falkm1980/Mp3-Player_HTL/README.md

# Mp3-Player_HTL
MP3 Player, HTL Saalfelden
