falkm1980/Mp3-Player_HTL/MP3_Player/Gehäuse/BOX G407.JPG

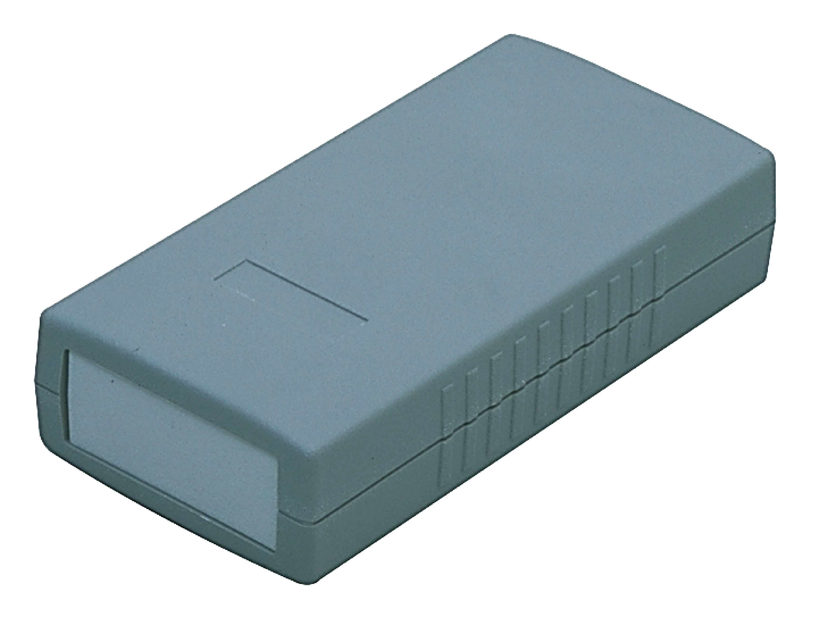
MP3_Player/Gehäuse/BOX G407.JPG
