falkm1980/Mp3-Player_HTL/MP3_Player/Gehäuse/BOXG407_LT.JPG

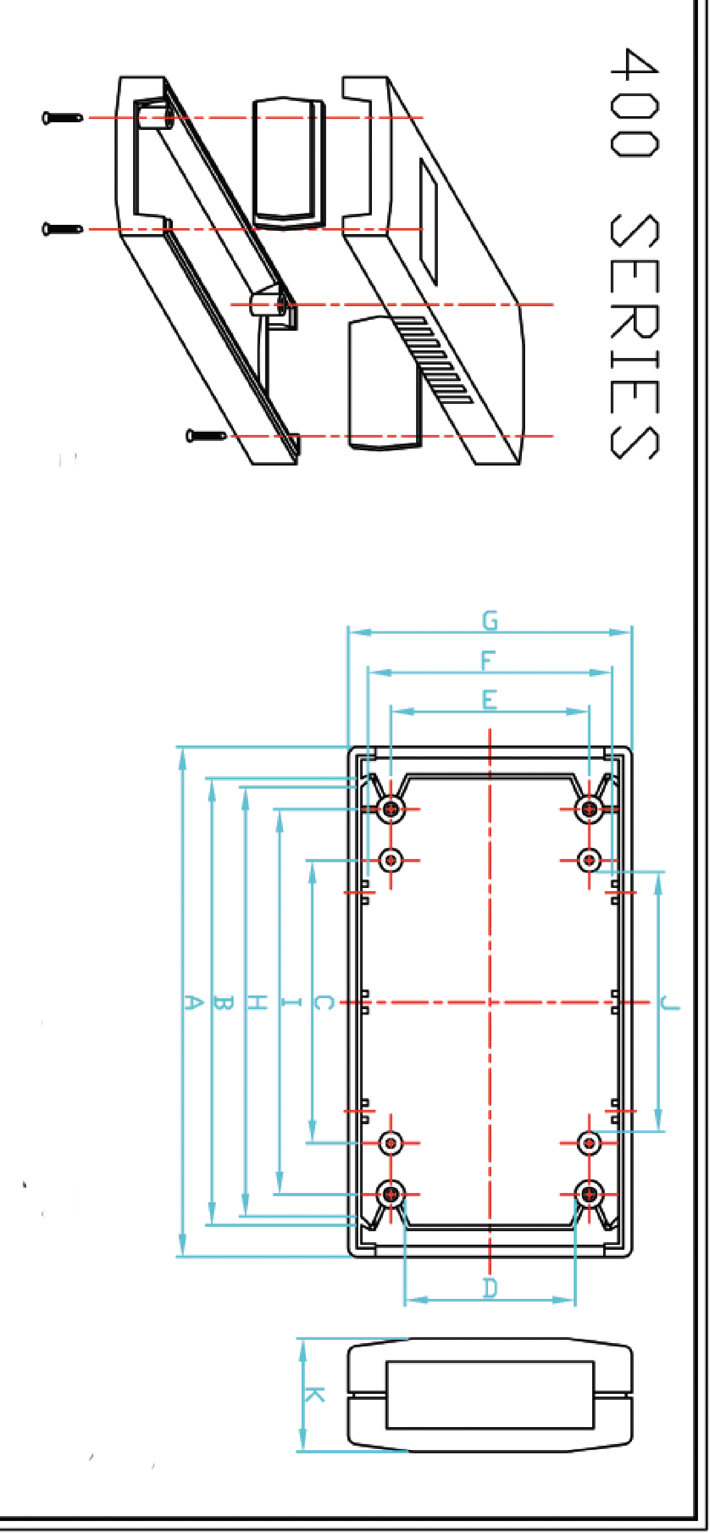
MP3_Player/Gehäuse/BOXG407_LT.JPG
