falkm1980/Mp3-Player_HTL/MP3_Player/Mouser/Warenkorb.PNG

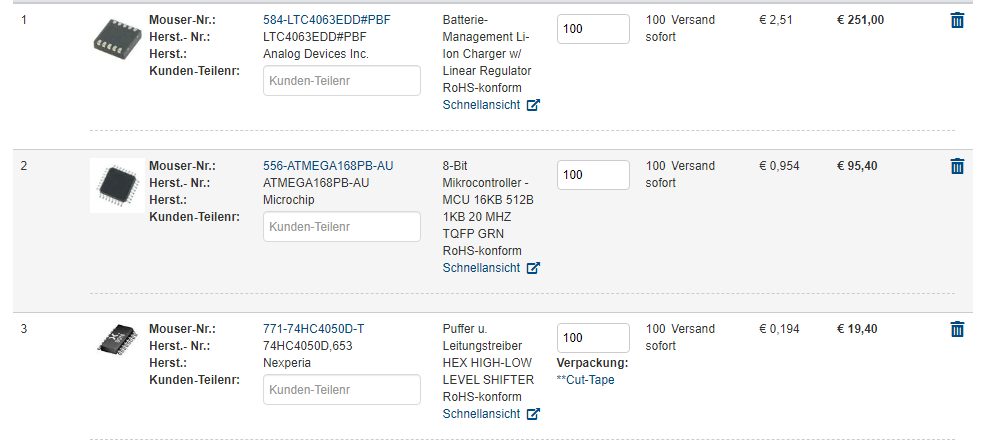
MP3_Player/Mouser/Warenkorb.PNG
