falkm1980/Mp3-Player_HTL/MP3_Player/Stückliste/MP3_Player_Stückliste.xlsx

 |  | Stückliste MP3 Player |  | RS |  |  |  | Bibliothek
Pos | Stück | Bezeichnung | Beschreibung | Bestellnummer | Gehäuse | Lieferant | Preis
 |  | ATMEGA 168 | Prozessor | 922-0749
 |  | VS1011E | Audio IC
 |  | BTM-222_Serial | Bluetooth
 |  | Quarz | 20MHz | 148-5634
 |  | Quarz | 12MHz | 148-5359
 |  | Klinkenbuchse |  | 909-2238 | Testboard | RS | 1.386
 |  | Klinkenbuchse | RS | 513-0421 | Testboard | RS | 1.42 | con_Hirschmann
 |  | Klinkenbuchse | Reichelt | LUM1503-02 | SMD | Reichelt
 |  | Klinkenbuchse | Reichelt | LUM1503-07 | Draht | Reichelt
 |  | LTC3455 |  | 153-3383
 |  | Elko | 10µ | 136-2654 | 1206 |  | 0.158
 |  | Elko | 47µ | 136-2598 | 1206
 |  | Kondensator | 27pF | 169-9964
 |  | LED Rot |  | 862-4695 |  |  | 0.097
 |  | LED Grün |  | 862-4691 |  |  | 0.1
 |  | LTC4063 | Mouser
 |  | Accu | Conrad | 252031-62
 |  | Accu | Mouser | 406-ASR00035
 |  | Gehäuse | Nedis | BOX G404
 |  | Akku | Reichelt | Akku 30083
 |  | Akku | Reichelt | AKKU CP 38 | 500mA
 |  | USB | RS | 136-2263
 |  | C1 | 33p | Bestellnummer | R1206
 |  | C2 | 33p |  | R1206
 |  | C3 | 100n |  | R1206
 |  | C4 | 100n |  | R1206
 |  | C5 | 100n |  | R1206
 |  | C6 | 100µ/16V |  | DU-6,3x7,7
 |  | C7 | 100µ/16V |  | DU-6,3x7,8
 |  | C8 | 22p |  | R1206
 |  | C9 | 22p |  | R1206
 |  | C10 | 2,2µ |  | R0805
 |  | C11 | 1µ |  | R0805
 |  | C12 | 0,1µ |  | R0805
 |  | R1 | 1M |  | R0805
 |  | R2 | 10K |  | 0207/10
 |  | R3 | 100K |  | R1206
 |  | R4 | 100K |  | R1206
 |  | R5 | 100K |  | R0805
 |  | R6 | 100K |  | R0806
 |  | R7 | 100K |  | R1206
 |  | R8 | 440K |  | R0806
 |  | R9 | 160K |  | R0806
 |  | R10 | 330R |  | R0806
 |  | R11 | 1k8 |  | R0806
 |  | R12 | 150R |  | R0806
 |  | R13 | 1K8 |  | R1206
 |  | R14 | 100K |  | R0806
 |  | R15 | 2M |  | R0806
 |  | R16 | 10K |  | 0207/10
 |  | R17 | 10K |  | 0207/10
 |  | R18 | 100K |  | 0207/10
 |  | R19 | 1K |  | 0207/10
