falkm1980/Mp3-Player_HTL/MP3_Player/RS-Components/Warenkorb.PNG

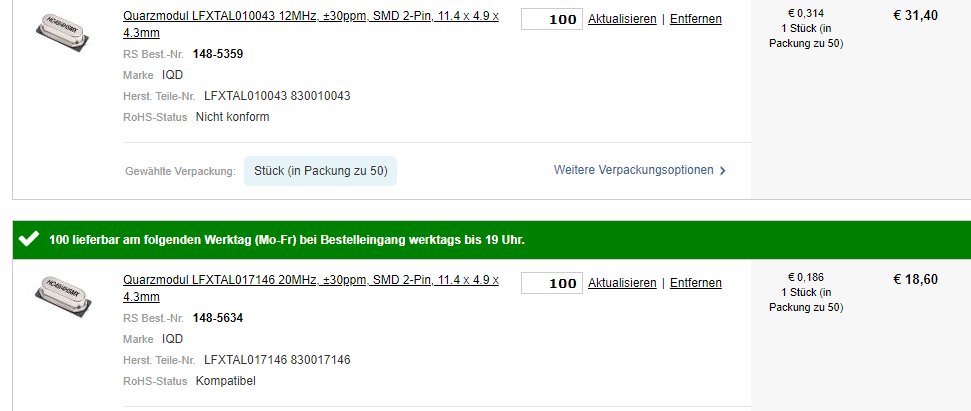
MP3_Player/RS-Components/Warenkorb.PNG
