falkm1980/Mp3-Player_HTL/EvaluationBoardLabor/datasheet/PCBA_rev4 2/Test Points/Assembly Testpoint Report for ATmega328P_Xplained_Mini_release_rev4.txt

Net         Name        X Coord     Y Coord     Side        Hole Size   Type        
PC0         J203-1          6.35mm     20.32mm  Bottom             1mm  Through hole
PC1         J203-2          6.35mm     17.78mm  Bottom             1mm  Through hole
PC3         J203-4          6.35mm      12.7mm  Bottom             1mm  Through hole
PC2         J203-3          6.35mm     15.24mm  Bottom             1mm  Through hole
PC5         J203-6          6.35mm      7.62mm  Bottom             1mm  Through hole
PC4         J203-5          6.35mm     10.16mm  Bottom             1mm  Through hole
PD0         J201-1         54.61mm      7.62mm  Bottom             1mm  Through hole
PD1         J201-2         54.61mm     10.16mm  Bottom             1mm  Through hole
PD3         J201-4         54.61mm     15.24mm  Bottom             1mm  Through hole
PD2         J201-3         54.61mm      12.7mm  Bottom             1mm  Through hole
PD6         J201-7         54.61mm     22.86mm  Bottom             1mm  Through hole
PD7         J201-8         54.61mm      25.4mm  Bottom             1mm  Through hole
PD5         J201-6         54.61mm     20.32mm  Bottom             1mm  Through hole
PD4         J201-5         54.61mm     17.78mm  Bottom             1mm  Through hole
PB4         J200-5         54.61mm    39.624mm  Bottom             1mm  Through hole
PB5         J200-6         54.61mm    42.164mm  Bottom             1mm  Through hole
AREF_TARGET J200-8         54.61mm    47.244mm  Bottom             1mm  Through hole
PB2         J200-3         54.61mm    34.544mm  Bottom             1mm  Through hole
PB3         J200-4         54.61mm    37.084mm  Bottom             1mm  Through hole
PB1         J200-2         54.61mm    32.004mm  Bottom             1mm  Through hole
PB0         J200-1         54.61mm    29.464mm  Bottom             1mm  Through hole
PC4         J200-9         54.61mm    49.784mm  Bottom             1mm  Through hole
PC5         J200-10        54.61mm    52.324mm  Bottom             1mm  Through hole
PD3_UART_TXD1J104-1         16.51mm     48.26mm  Bottom             1mm  Through hole
PD2_UART_RXD1J104-2         16.51mm      50.8mm  Bottom             1mm  Through hole
TDI         J100-9          50.8mm    56.515mm  Bottom          0.65mm  Through hole
VCC_BOARD   J100-4         46.99mm    57.785mm  Bottom          0.65mm  Through hole
S\R\S\T\    J100-6         48.26mm    57.785mm  Bottom          0.65mm  Through hole
NetJ100_8   J100-8         49.53mm    57.785mm  Bottom          0.65mm  Through hole
NetJ100_7   J100-7         49.53mm    56.515mm  Bottom          0.65mm  Through hole
TMS         J100-5         48.26mm    56.515mm  Bottom          0.65mm  Through hole
TDO         J100-3         46.99mm    56.515mm  Bottom          0.65mm  Through hole
TCK         J100-1         45.72mm    56.515mm  Bottom          0.65mm  Through hole
VCC_TARGET  J204-2         34.24mm      4.94mm  Bottom             1mm  Through hole
PB3         J204-4          31.7mm      4.94mm  Bottom             1mm  Through hole
PB4         J204-1         34.24mm      7.48mm  Bottom             1mm  Through hole
PB5         J204-3          31.7mm      7.48mm  Bottom             1mm  Through hole
R\E\S\E\T\  J204-5         29.16mm      7.48mm  Bottom             1mm  Through hole
NetJ202_1   J202-1          6.35mm     43.18mm  Bottom             1mm  Through hole
VCC_TARGET  J202-2          6.35mm     40.64mm  Bottom             1mm  Through hole
VCC_P3V3    J202-4          6.35mm     35.56mm  Bottom             1mm  Through hole
RESET_SENSE J202-3          6.35mm      38.1mm  Bottom             1mm  Through hole
GND         J202-7          6.35mm     27.94mm  Bottom             1mm  Through hole
VCC_VIN     J202-8          6.35mm      25.4mm  Bottom             1mm  Through hole
VCC_P5V0    Free-0          3.81mm     33.02mm  Bottom             1mm  Through hole
ADC6        Free-5         16.51mm      25.4mm  Bottom             1mm  Through hole
ADC7        Free-5         16.51mm     22.86mm  Bottom             1mm  Through hole
GND         Via            29.65mm     67.33mm  Bottom          0.25mm  Through hole
NetD100_1   Via           29.275mm   35.4457mm  Bottom          0.25mm  Through hole
VCC_VBUS    Via            34.35mm    67.275mm  Bottom          0.25mm  Through hole
USBD_P      Via            29.65mm      68.6mm  Bottom          0.25mm  Through hole
USBD_N      Via               31mm      68.6mm  Bottom          0.25mm  Through hole
POWER_ENABLEVia          27.8775mm    38.825mm  Bottom          0.25mm  Through hole
NetU100_8   Via          27.6477mm   52.1667mm  Bottom          0.25mm  Through hole
NetU100_12  Via           26.075mm   49.6397mm  Bottom          0.25mm  Through hole
DEBUGWIRE   Via             28.7mm      42.2mm  Bottom          0.25mm  Through hole
PB7         Via            30.25mm    16.075mm  Bottom          0.25mm  Through hole
NetU100_18  Via          24.9262mm   46.0273mm  Bottom          0.25mm  Through hole
NetU100_22  Via            25.85mm    43.125mm  Bottom          0.25mm  Through hole
NetU100_19  Via           23.975mm    42.875mm  Bottom          0.25mm  Through hole
NetJ102_2   Via          33.1836mm   42.8189mm  Bottom          0.25mm  Through hole
EXT_CLK     Via            29.85mm      41.5mm  Bottom          0.25mm  Through hole
