falkm1980/Mp3-Player_HTL/MP3_Player/Stückliste/Anleitung MP3-Gehäuse.docx

Anleitung MP3-Player Gehäuse gravieren

1. Beginnend muss der Computer eingeschalten werden und das Programm „GS 8 Gravostyle“ gestartet werden. Zusätzlich ist das Laserschneidegerät, wie in den nachfolgenden Bildern zu sehen, ebenfalls zu starten.

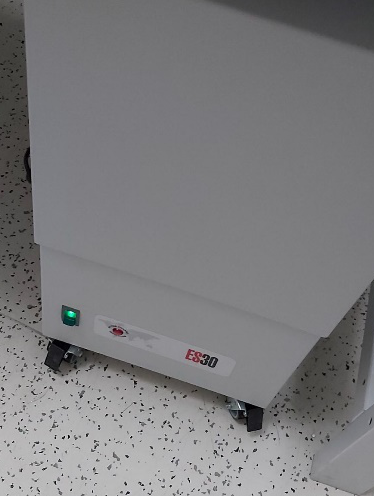
[picture p5: figure]
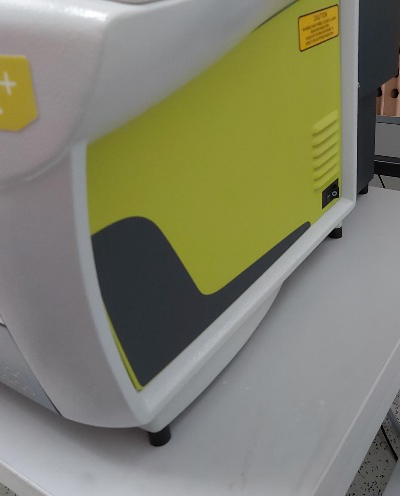
[picture p6: figure]
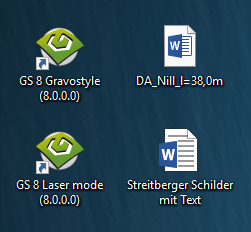
[picture p7: figure]
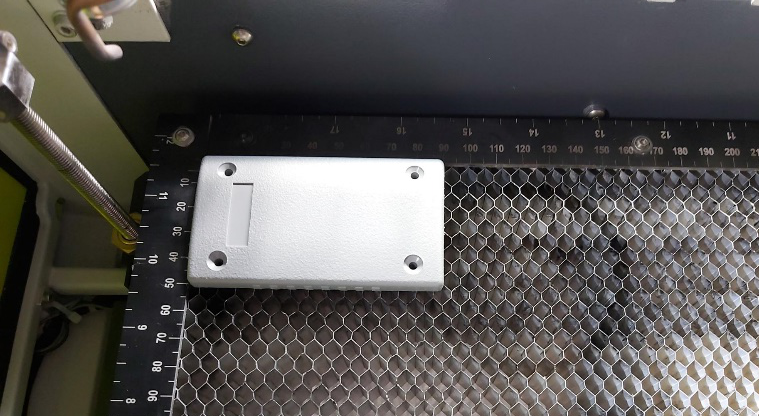
[picture p8: figure]

2. Dann muss als erstes der schmälere Teil des Gehäuses, mit der Einkerbung nach links, in die Lasermaschine eingelegt werden.
3. Danach muss im Laserprogramm in „Dateien öffnen“ der Richtige Ablauf gewählt werden. Als erstes wird in diesem Fall „MP3_Lochausschnitt“ geöffnet. Sobald die Datei geöffnet ist, kann wie im unteren Bild ersichtlich auf Beschriften und schließlich auf Start geklickt werden um den Laser zu starten.

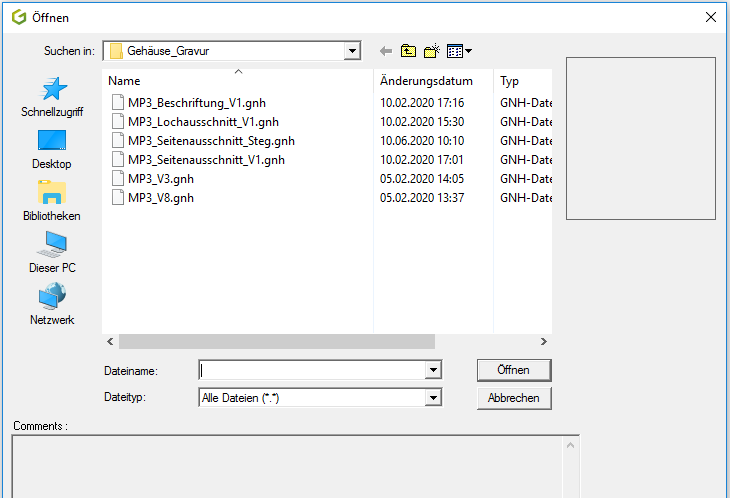
[picture p9: figure]
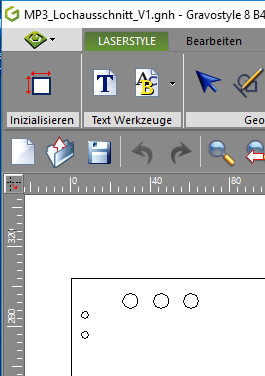
[picture p10: figure]
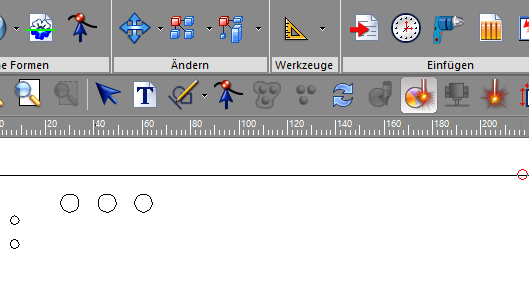
[picture p11: figure]
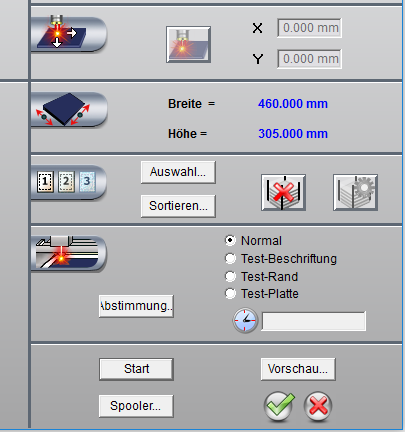
[picture p12: figure]

4. Um den Ablauf an der Lasermaschine beginnen zu können, muss man jedes Mal den grünen Knopf betätigen.

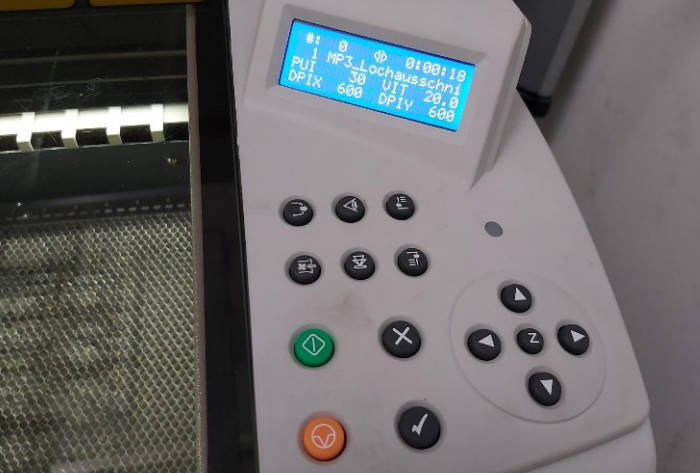
[picture p13: figure]

5. Im nächsten Schritt wird wieder in Dateien der nächste Ablauf ausgewählt –

„MP3_Beschriftung“. Das eingelegte Gehäuseteil bleibt dabei an der gleichen Stelle. Die weiteren Schritte sind gleich wie bei den Punkten 3 und 4.

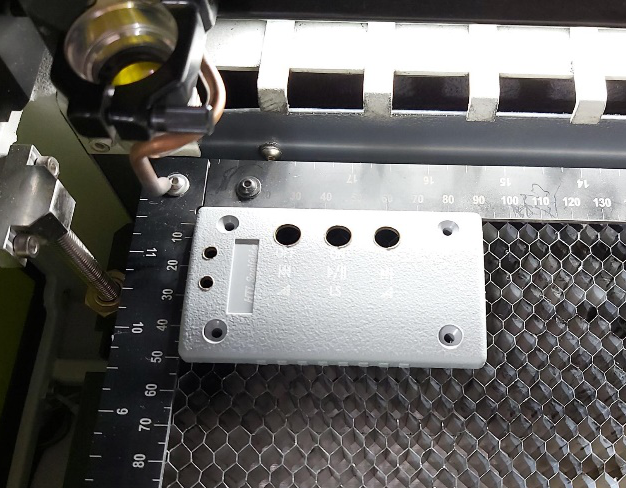
[picture p14: figure]
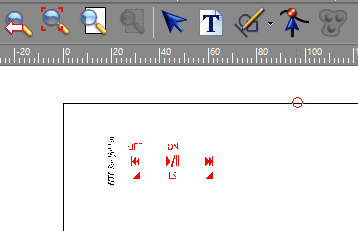
[picture p15: figure]

6. Nun muss das breitere Gehäuseteil mit der Einkerbung nach rechts Hochkant, wie im Bild ersichtlich, an das Aluminiumstück, mit Tixo, befestigt werden. Und anschließend wird es wieder in das Gerät eingelegt.

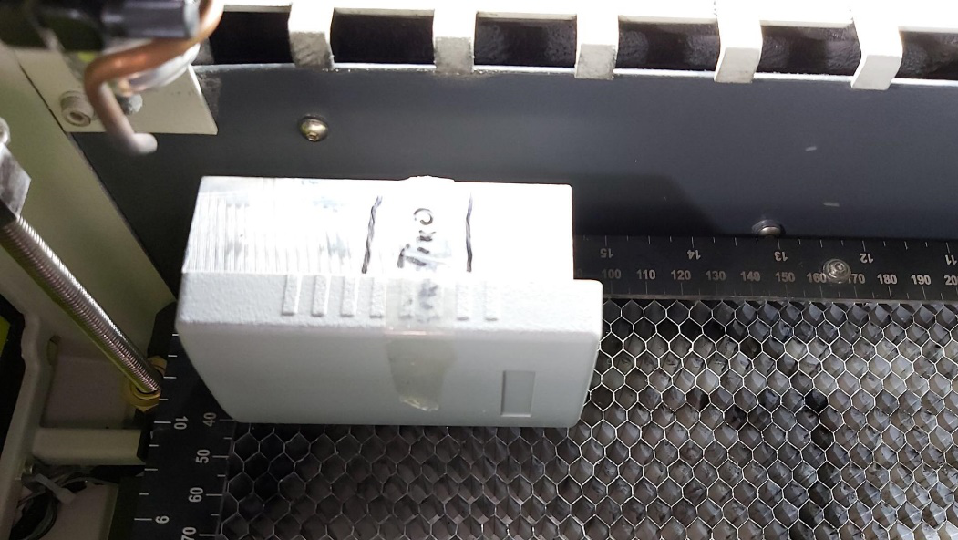
[picture p16: figure]

7. Danach wird wieder der richtige Ablauf in den Dateien ausgewählt – „MP3_Seitenausschnitt_Steg“. Die nachfolgenden Schritte sind wieder identisch zu den Punkten bei 3 und 4. Beim Seitenausschnitt muss das Programm zwei Mal durchlaufen um so einen Durchschnitt zu gewährleisten das heißt einfach nochmal auf Beschriften und Starten klicken.

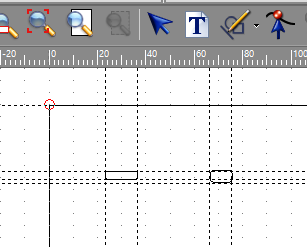
[picture p17: figure]
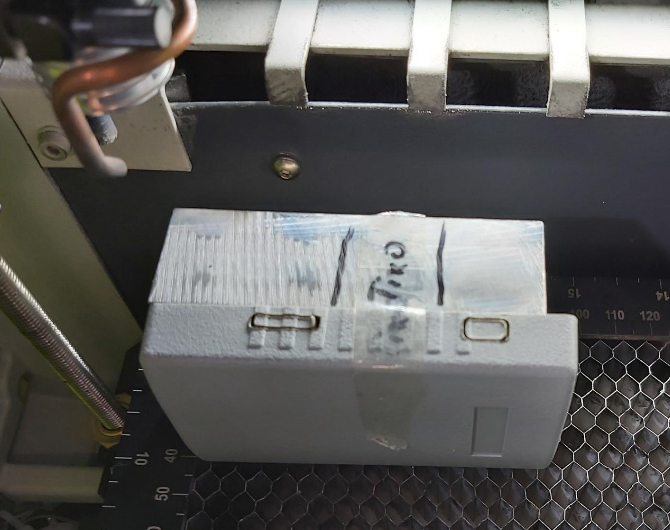
[picture p18: figure]
