falkm1980/Mp3-Player_HTL/MP3_Player/Stückliste/Platine Anleitung.docx

MP3-Player Projekt Anleitung zur Erstellung der Platine

1. Rohmaterial zuschneiden.

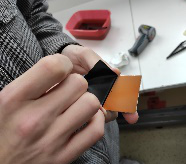
[picture p19: figure]

2. Schutzfolie entfernen.

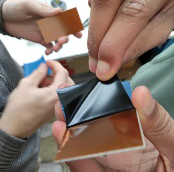
[picture p20: figure]
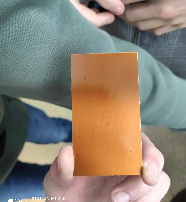
[picture p21: figure]

3. Platine mit UV Licht belichten um das Platinen Layout aufzubringen.

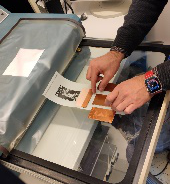
[picture p22: figure]
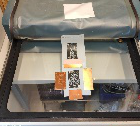
[picture p23: figure]
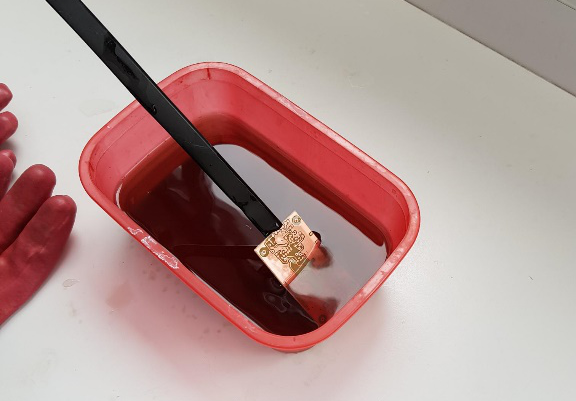
[picture p24: figure]

4. Entwickeln mit Natriumhydroxid [NaOh] um den Foto Lack zu lösen.
5. Ätzen mit Natriumpersulfat [Na2S2O8] um das Kupfer zu entfernen und die Leiterbahnen freizulegen

Durchs Ätzen Wird die Flüssigkeit blau, da sich das Kupfer darin löst.

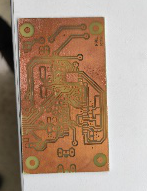
[picture p25: figure]
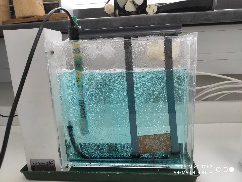
[picture p26: figure]
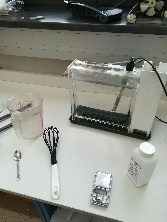
[picture p27: figure]

6. Bohren der Übergänge nach Schaltplan

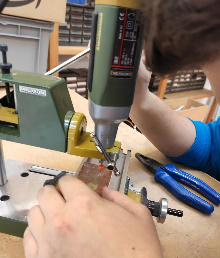
[picture p28: figure]
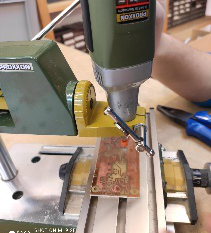
[picture p29: figure]

7. Nochmals belichten und entwickeln um den restlichen Foto Lack zu entfernen

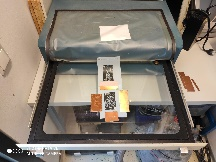
[picture p30: figure]
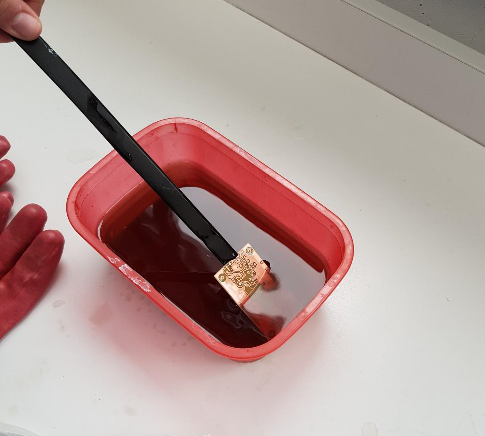
[picture p31: figure]
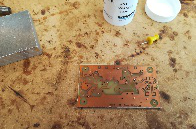
[picture p32: figure]

8. Nieten um eine Verbindung von der Top Seite auf die Botton Seite zu gewährleisten
9. Abschließend die Platine bestücken und testen bevor sie in das Gehäuse verbaut wird
