falkm1980/Mp3-Player_HTL/Testboard/SMD Adapter/Pinbelegung_Adapter.xlsm

TQFP32 | DIL32 |  | SOIC28 | DIL28
1 | 21 |  | 1
2 | 22 |  | 2
3 | 23 |  | 3
4 | 24 |  | 4
5 | 25 |  | 5
6 | 26 |  | 6
7 | 27 |  | 7
8 | 28 |  | 8
9 | 29 |  | 9
10 | 30 | x | 10
11 | 31 | x | 11
12 | 32 | x | 12
13 | 1 |  | 13
14 | 2 |  | 14
15 | 3 |  | 15
16 | 4 |  | 16
17 | 5 |  | 17
18 | 6 | x | 18
19 | 7 | x | 19
20 | 8 | x | 20
21 | 9 |  | 21
22 | 10 | x | 22
23 | 11 |  | 23
24 | 12 |  | 24
25 | 13 | x | 25
26 | 14 |  | 26
27 | 15 |  | 27
28 | 16 |  | 28
29 | 17
30 | 18 | x
31 | 19 | x
32 | 20
