falkm1980/Mp3-Player_HTL/EvaluationBoardLabor/pcb/mp3playerLabor_v1.pdf

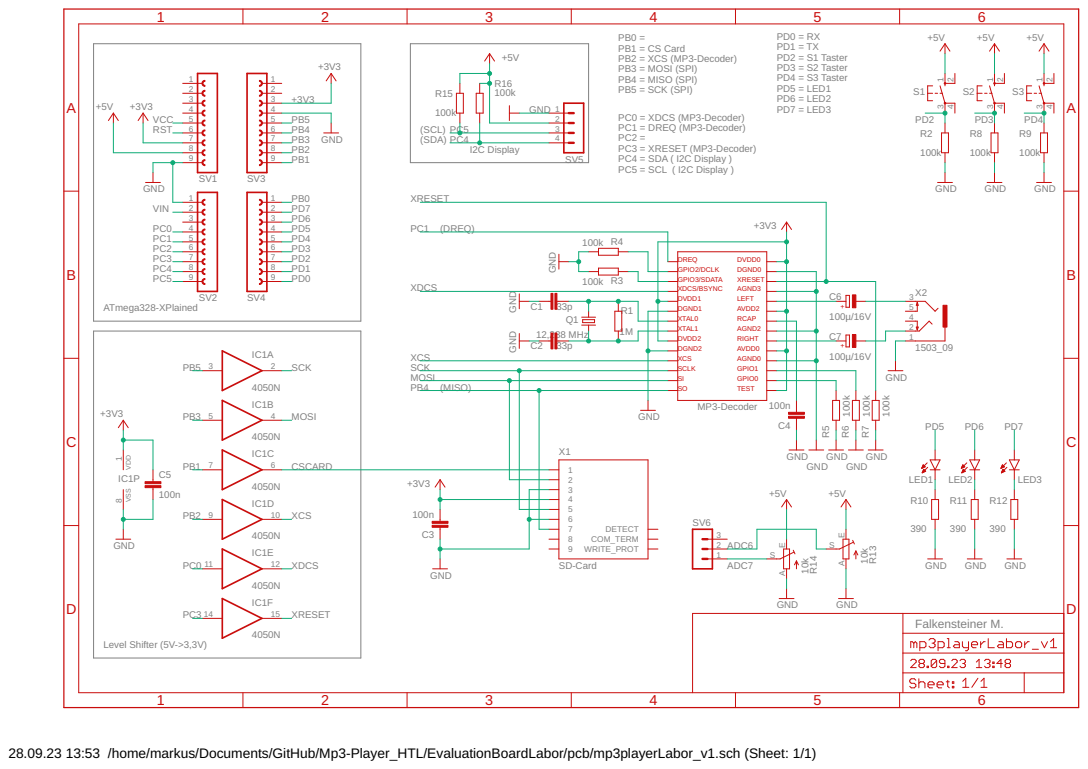
[picture p33: page 1]

28.09.23 13:53 /home/markus/Documents/GitHub/Mp3-Player_HTL/EvaluationBoardLabor/pcb/mp3playerLabor_v1.sch (Sheet: 1/1)
