falkm1980/Mp3-Player_HTL/EvaluationBoardLabor/pcb/mp3playerLabor_v1.brd.pdf

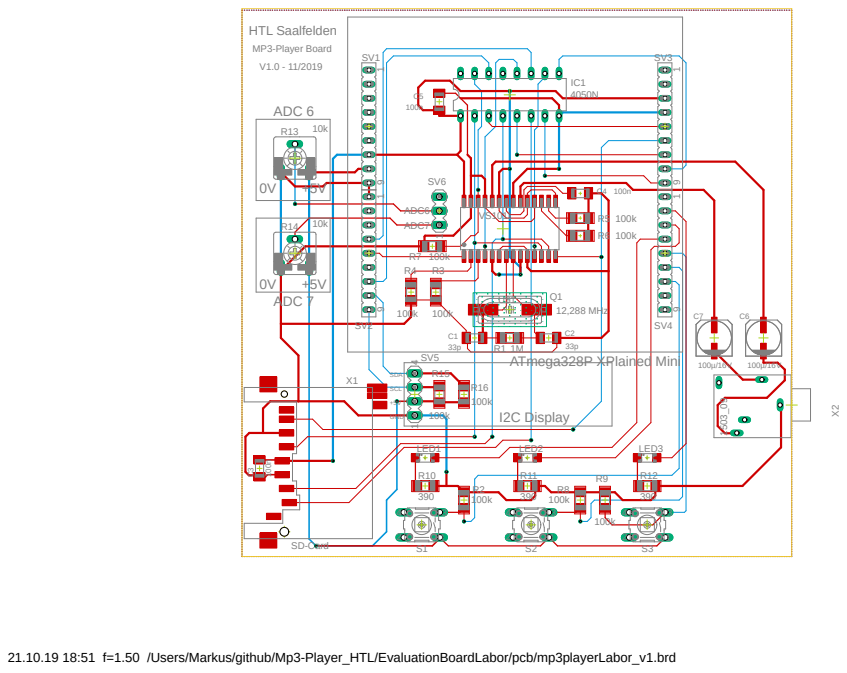
[picture p34: page 1]

21.10.19 18:51 f=1.50 /Users/Markus/github/Mp3-Player_HTL/EvaluationBoardLabor/pcb/mp3playerLabor_v1.brd
