falkm1980/Mp3-Player_HTL/(list of files, drawings)

Other design files:
EvaluationBoardLabor/datasheet/PCBA_rev4 2/ATmega328P_Xplained_Mini_CAD_source_PCBA_rev4/ATmega328P_Xplained_Mini.PrjPCB
EvaluationBoardLabor/datasheet/PCBA_rev4 2/ATmega328P_Xplained_Mini_CAD_source_PCBA_rev4/ATmega328P_Xplained_Mini_Programmer.SchDoc
EvaluationBoardLabor/datasheet/PCBA_rev4 2/ATmega328P_Xplained_Mini_CAD_source_PCBA_rev4/ATmega328P_Xplained_Mini_Target.SchDoc
EvaluationBoardLabor/datasheet/PCBA_rev4 2/ATmega328P_Xplained_Mini_CAD_source_PCBA_rev4/ATmega328P_Xplained_Mini_TopLevel.SchDoc
