falkm1980/Mp3-Player_HTL/EvaluationBoardLabor/pcb/mp3playerLabor_v1.brd

## EAGLE design EvaluationBoardLabor/pcb/mp3playerLabor_v1.brd (2019-10-12)

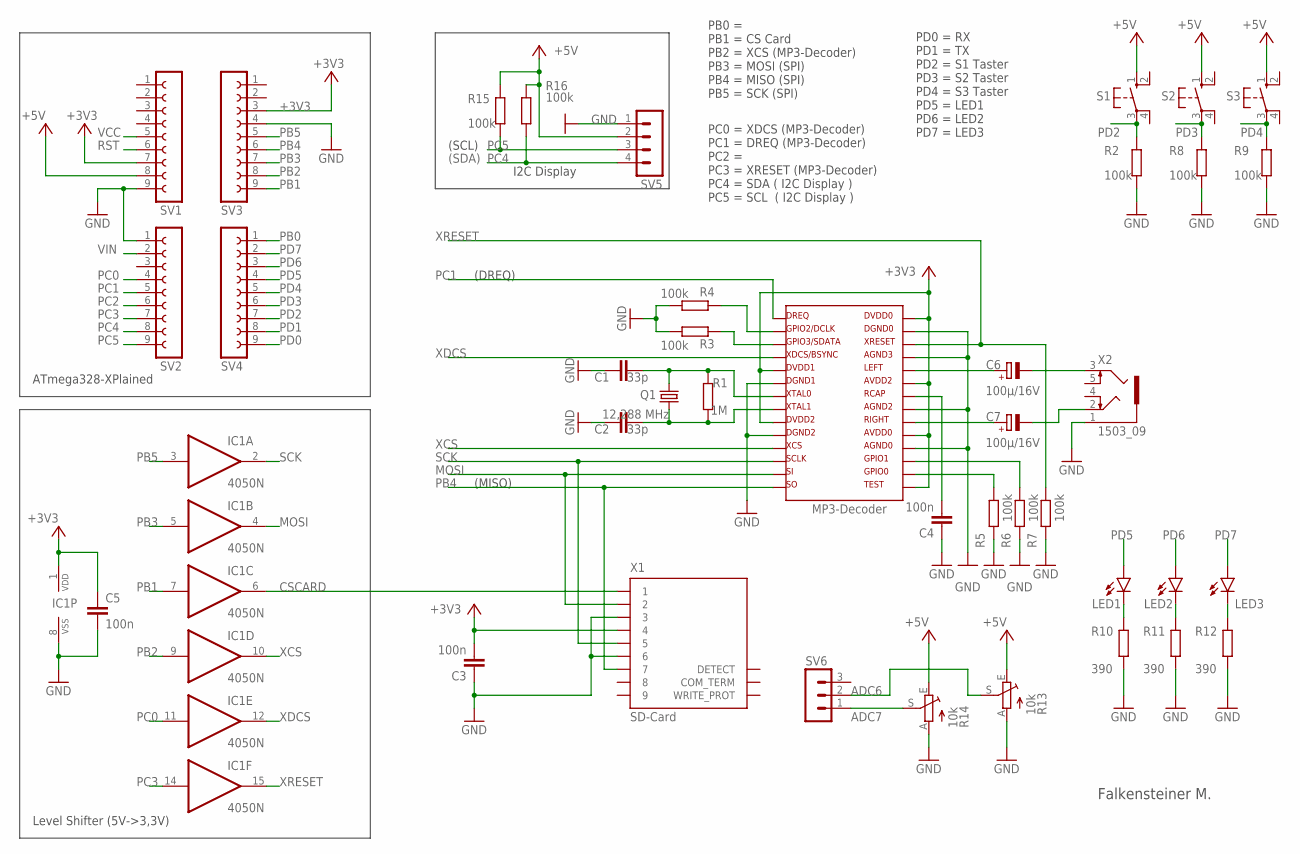
[picture p35: schematic mp3playerLabor_v1.sch]

Parts:
C1, C2: 33p; C1206K
C3, C4, C5: 100n; C1206K
C6, C7: 100µ/16V; UD-6,3X7,7_NICHICON
IC1: 4050N; DIL16
LED1, LED2, LED3: LEDSML1206; SML1206
Q1: 12,288 MHz; HC49UP
R1: 1M; R1206
R2, R3, R4, R5, R6, R7, R8, R9, R15, R16: 100k; R1206
R10, R11, R12: 390; R1206
R13, R14: 10k; CA6V
S1, S2, S3: 10-XX; B3F-10XX
SV1, SV2, SV3, SV4: FE09-1; FE09
SV5: MA04-1
SV6: MA03-1
U$1: VS1011; SOIC-28
X1: SD-Card; FPS009-3000
X2: 1503_09

Connections:
+3V3: C3.2, C5.1, IC1.1 (VDD), SV1.7, SV3.3, U$1.5, U$1.9, U$1.15, U$1.19, U$1.23, U$1.28, X1.4
+5V: R13.E, R14.E, R15.1, R16.1, S1.1 (S), S2.1 (S), S3.1 (S), SV1.8, SV5.2
ADC6: R13.S, SV6.2
ADC7: R14.S, SV6.1
CSCARD: IC1.6 (O), X1.1
GND: C1.1, C2.1, C3.1, C4.1, C5.2, IC1.8 (VSS), R2.2, R3.2, R4.2, R5.2, R6.2, R7.2, R8.2, R9.2, R10.2, R11.2, R12.2, R13.A, R14.A, SV1.9, SV2.1, SV3.4, SV5.1, U$1.6, U$1.10, U$1.18, U$1.21, U$1.25, U$1.27, X1.3, X1.6, X2.1
MOSI: IC1.4 (O), U$1.13, X1.2
unnamed: LED1.C, R10.1
unnamed: LED2.C, R11.1
unnamed: C2.2, Q1.1, R1.1, U$1.8
unnamed: LED3.C, R12.1
unnamed: C4.2, U$1.22
unnamed: R3.1, U$1.3
unnamed: C1.2, Q1.2, R1.2, U$1.7
unnamed: R4.1, U$1.2
unnamed: R6.1, U$1.17
unnamed: R5.1, U$1.16
unnamed: C7.+, U$1.20
unnamed: C6.+, U$1.24
unnamed: C6.-, X2.3
unnamed: C7.-, X2.2
PB0: SV4.1
PB1: IC1.7 (I), SV3.9
PB2: IC1.9 (I), SV3.8
PB3: IC1.5 (I), SV3.7
PB4: SV3.6, U$1.14, X1.7
PB5: IC1.3 (I), SV3.5
PC0: IC1.11 (I), SV2.4
PC1: SV2.5, U$1.1
PC2: SV2.6
PC3: IC1.14 (I), SV2.7
PC4: R16.2, SV2.8, SV5.4
PC5: R15.2, SV2.9, SV5.3
PD0: SV4.9
PD1: SV4.8
PD2: R2.1, S1.3, SV4.7
PD3: R8.1, S2.3, SV4.6
PD4: R9.1, S3.3, SV4.5
PD5: LED1.A, SV4.4
PD6: LED2.A, SV4.3
PD7: LED3.A, SV4.2
RST: SV1.6
SCK: IC1.2 (O), U$1.12, X1.5
VCC: SV1.5
VIN: SV2.2
XCS: IC1.10 (O), U$1.11
XDCS: IC1.12 (O), U$1.4
XRESET: IC1.15 (O), R7.1, U$1.26

Notes on the sheet:
Falkensteiner M.
PB0 = PB1 = CS Card PB2 = XCS (MP3-Decoder) PB3 = MOSI (SPI) PB4 = MISO (SPI) PB5 = SCK (SPI)
(MISO)
ATmega328-XPlained
PC0 = XDCS (MP3-Decoder) PC1 = DREQ (MP3-Decoder) PC2 = PC3 = XRESET (MP3-Decoder) PC4 = SDA ( I2C Display ) PC5 = SCL ( I2C Display )
Level Shifter (5V->3,3V)
PD0 = RX PD1 = TX PD2 = S1 Taster PD3 = S2 Taster PD4 = S3 Taster PD5 = LED1 PD6 = LED2 PD7 = LED3
MP3-Decoder
(DREQ)
(SCL)
(SDA)
I2C Display

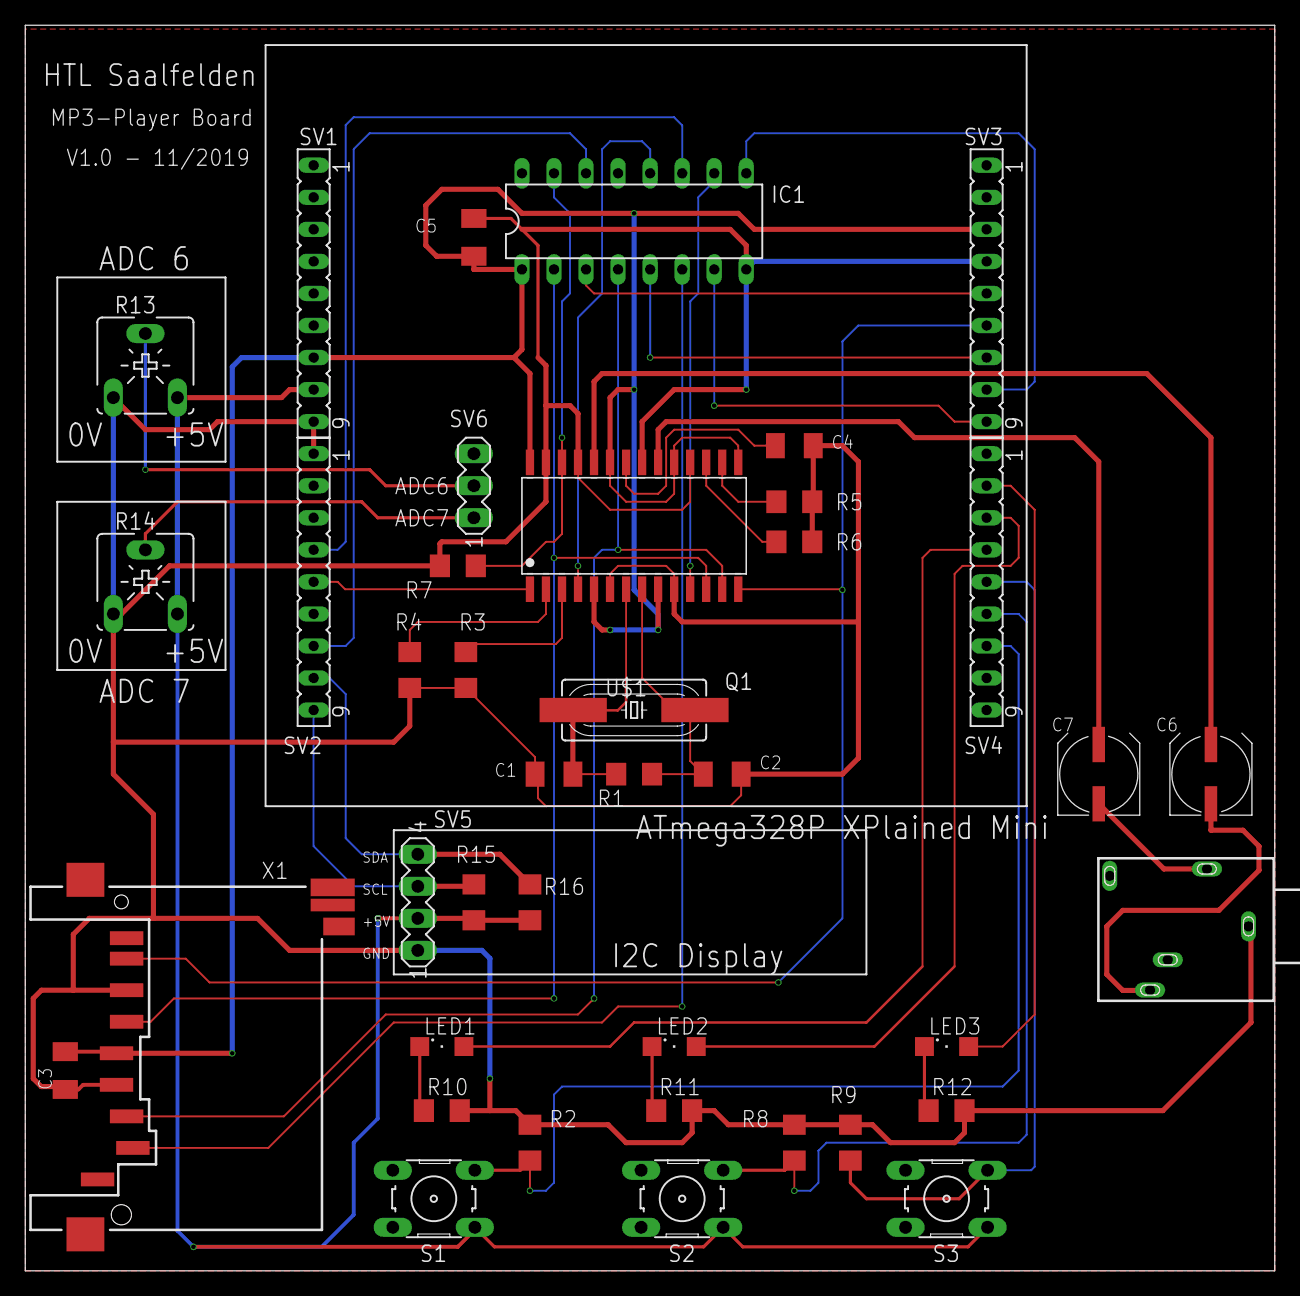
[picture p36: board mp3playerLabor_v1.brd from above]

Board: 2 copper layers, 99.0 x 98.7 mm, 40 parts (0 on the bottom side), 41 nets.
