falkm1980/Mp3-Player_HTL/MP3_Player/Platine_Version_6/mp3player_v6_Laderegler_LTC4063.brd

## EAGLE design MP3_Player/Platine_Version_6/mp3player_v6_Laderegler_LTC4063.brd (2019-05-24, an earlier design)

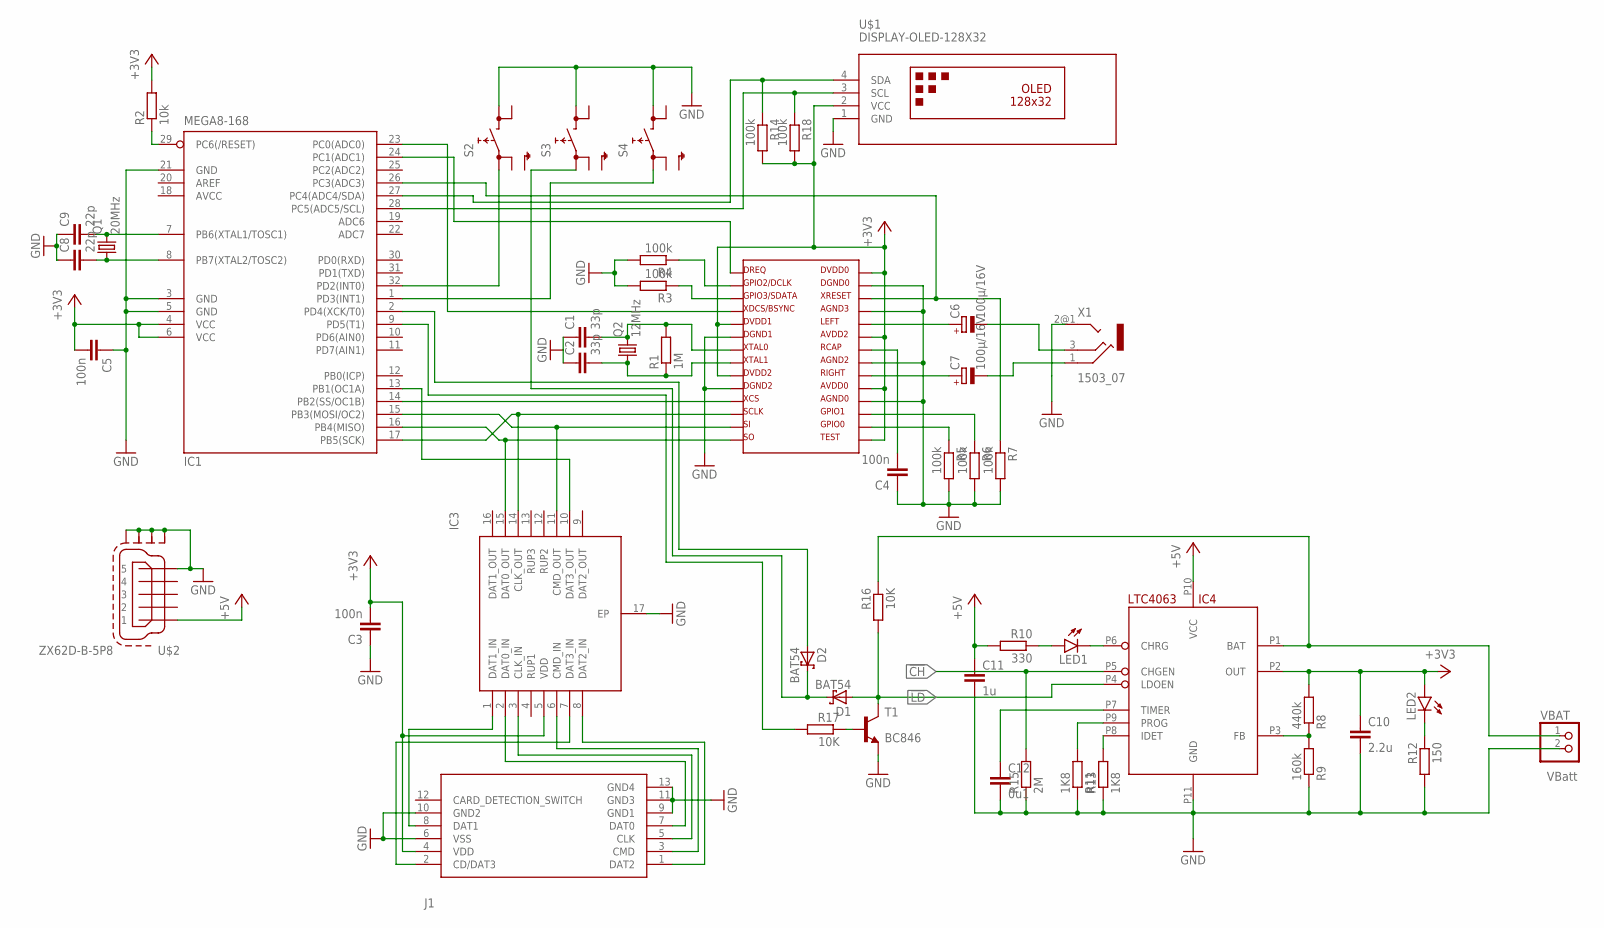
[picture p37: schematic mp3player_v6_Laderegler_LTC4063.sch]

Parts:
C1, C2: 33p; C1206K
C3, C4, C5: 100n; C1206K
C6, C7: 100µ/16V; UD-6,3X7,7_NICHICON
C8, C9: 22p; C1206K
C10: 2.2u; C0805K
C11: 1u; C0805K
C12: 0u1; C0805K
D1, D2: BAT54; SOT23
IC1: MEGA8-168; TQFP32-08
IC2: VS1011; SOIC-28
IC3: ECLAMP2410P.TCT; SON50P160X400X65-17N
IC4: LTC4063
J1: DM3CS-SF
LED1, LED2: LG_T679-E1F1-1; PLCC2
Q1: 20MHz; HC49UP
Q2: 12MHz; HC49UP
R1: 1M; R0805
R2: 10k; 0207/7
R3, R4, R5, R6, R14, R18: 100k; R0805
R7: 100k; 0207/15
R8: 440k; R0805
R9: 160k; R0805
R10: 330; R0805
R11, R13: 1K8; R0805
R12: 150; R0805
R15: 2M; R0805
R16: 10K; 0207/7
R17: 10K; R0805
S2, S3, S4: SKHMPSE010; SKHMPXE010
T1: BC846; SOT23
U$1: DISPLAY-OLED-128X32
U$2: ZX62D-B-5P8
VBAT: PINHD-1X2; 1X02
X1: 1503_07

Connections:
!CH: IC4.P5 (CHGEN), R15.2
!LD: D1.1 (A), IC4.P4 (LDOEN), R16.2, T1.3 (C)
+3V3: C3.2, C5.2, C10.1, IC1.4 (VCC), IC1.6 (VCC), IC2.5, IC2.9, IC2.15, IC2.19, IC2.23, IC2.28, IC3.5 (VDD), IC4.P2 (OUT), J1.4 (VDD), LED2.A, R2.2, R8.2, R14.2, R18.2, U$1.2 (VCC)
+5V: C11.1, IC4.P10 (VCC), R10.2, U$2.P$1 (1)
AVCC: IC1.18 (AVCC)
GND: C1.1, C2.1, C3.1, C4.1, C5.1, C8.1, C9.1, C10.2, C11.2, C12.2, IC1.3 (GND), IC1.5 (GND), IC1.21 (GND), IC2.6, IC2.10, IC2.18, IC2.21, IC2.25, IC2.27, IC3.17 (EP), IC4.P11 (GND), J1.6 (VSS), J1.9 (GND1), J1.10 (GND2), J1.11 (GND3), J1.13 (GND4), R3.2, R4.2, R5.2, R6.2, R7.2, R9.1, R11.1, R12.2, R13.1, R15.1, S2.3 (2.1), S3.3 (2.1), S4.3 (2.1), T1.2 (E), U$1.1 (GND), U$2.P$5 (5), U$2.SH1, U$2.SH2, U$2.SH3, U$2.SH4, VBAT.2, X1.2@1 (2)
unnamed: IC1.17 (PB5(SCK)), IC2.12, IC3.14 (CLK_OUT)
unnamed: IC1.16 (PB4(MISO)), IC2.14, IC3.15 (DAT0_OUT)
unnamed: IC1.15 (PB3(MOSI/OC2)), IC2.13, IC3.11 (CMD_OUT)
unnamed: IC1.14 (PB2(SS/OC1B)), IC2.11
unnamed: C2.2, IC2.8, Q2.1, R1.1
unnamed: IC1.23 (PC0(ADC0)), IC2.4
unnamed: C4.2, IC2.22
unnamed: IC2.3, R3.1
unnamed: C1.2, IC2.7, Q2.2, R1.2
unnamed: IC2.2, R4.1
unnamed: IC1.32 (PD2(INT0)), S2.1 (1.1)
unnamed: IC2.17, R6.1
unnamed: IC2.16, R5.1
unnamed: IC1.24 (PC1(ADC1)), IC2.1
unnamed: D2.1 (A), IC1.2 (PD4(XCK/T0))
unnamed: IC1.26 (PC3(ADC3)), IC2.26, R7.1
unnamed: IC1.29 (PC6(/RESET)), R2.1
unnamed: C7.+, IC2.20
unnamed: C6.+, IC2.24
unnamed: IC1.1 (PD3(INT1)), S4.1 (1.1)
unnamed: C6.-, X1.3
unnamed: C7.-, X1.1
unnamed: C8.2, IC1.8 (PB7(XTAL2/TOSC2)), Q1.1
unnamed: C9.2, IC1.7 (PB6(XTAL1/TOSC1)), Q1.2
unnamed: IC3.1 (DAT1_IN), J1.8 (DAT1)
unnamed: IC3.8 (DAT2_IN), J1.1 (DAT2)
unnamed: IC4.P3 (FB), R8.1, R9.2
unnamed: IC3.7 (DAT3_IN), J1.2 (CD/DAT3)
unnamed: IC3.2 (DAT0_IN), J1.7 (DAT0)
unnamed: IC3.3 (CLK_IN), J1.5 (CLK)
unnamed: IC3.6 (CMD_IN), J1.3 (CMD)
unnamed: IC4.P1 (BAT), R16.1, VBAT.1
unnamed: LED1.A, R10.1
unnamed: IC4.P9 (PROG), R11.2
unnamed: IC4.P6 (CHRG), LED1.C
unnamed: LED2.C, R12.1
unnamed: IC4.P8 (IDET), R13.2
unnamed: C12.1, IC4.P7 (TIMER)
unnamed: IC1.27 (PC4(ADC4/SDA)), R14.1, U$1.4 (SDA)
unnamed: IC1.28 (PC5(ADC5/SCL)), R18.1, U$1.3 (SCL)
unnamed: IC1.13 (PB1(OC1A)), IC3.10 (DAT3_OUT)
unnamed: R17.1, T1.1 (B)
unnamed: IC1.9 (PD5(T1)), R17.2
unnamed: D1.3 (C), D2.3 (C), S3.1 (1.1)

Notes on the sheet:
VBatt

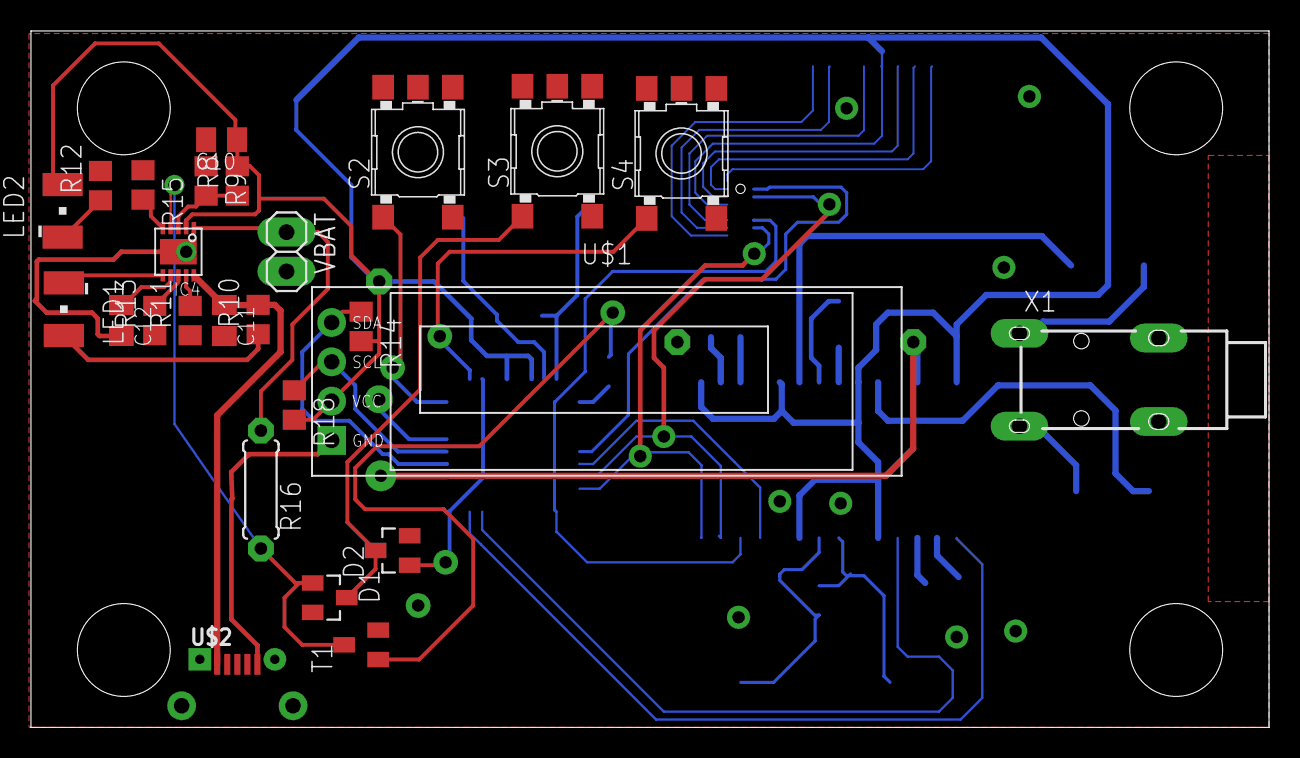
[picture p38: board mp3player_v6_Laderegler_LTC4063.brd from above]

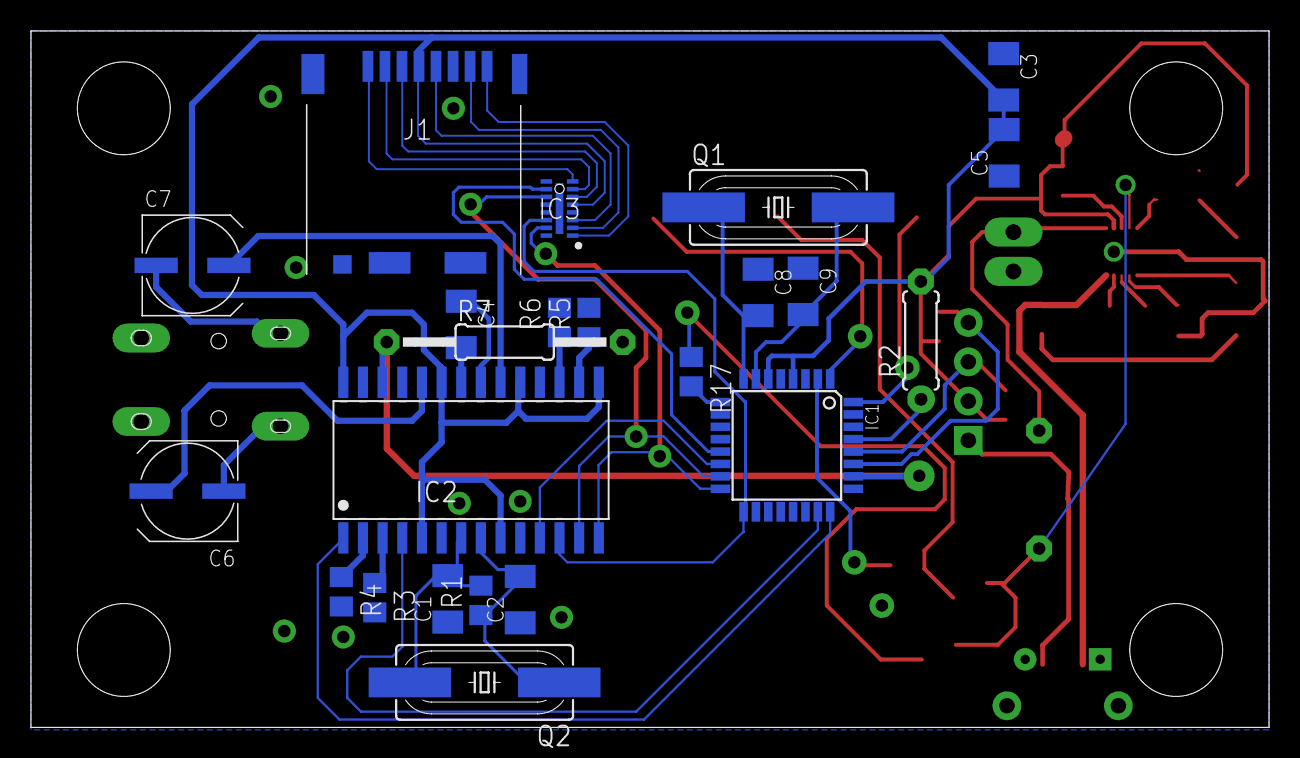
[picture p39: board mp3player_v6_Laderegler_LTC4063.brd from below]

Board: 2 copper layers, 80.0 x 45.0 mm, 49 parts (23 on the bottom side), 49 nets.
