falkm1980/Mp3-Player_HTL/MP3_Player/Laderegler_LTC4063/Eagle-LTC4063-master/Eagle-LTC4063-master/LTC4063-TestBoard_nicht SMD.brd

## EAGLE design MP3_Player/Laderegler_LTC4063/Eagle-LTC4063-master/Eagle-LTC4063-master/LTC4063-TestBoard_nicht SMD.brd (2019-09-27)

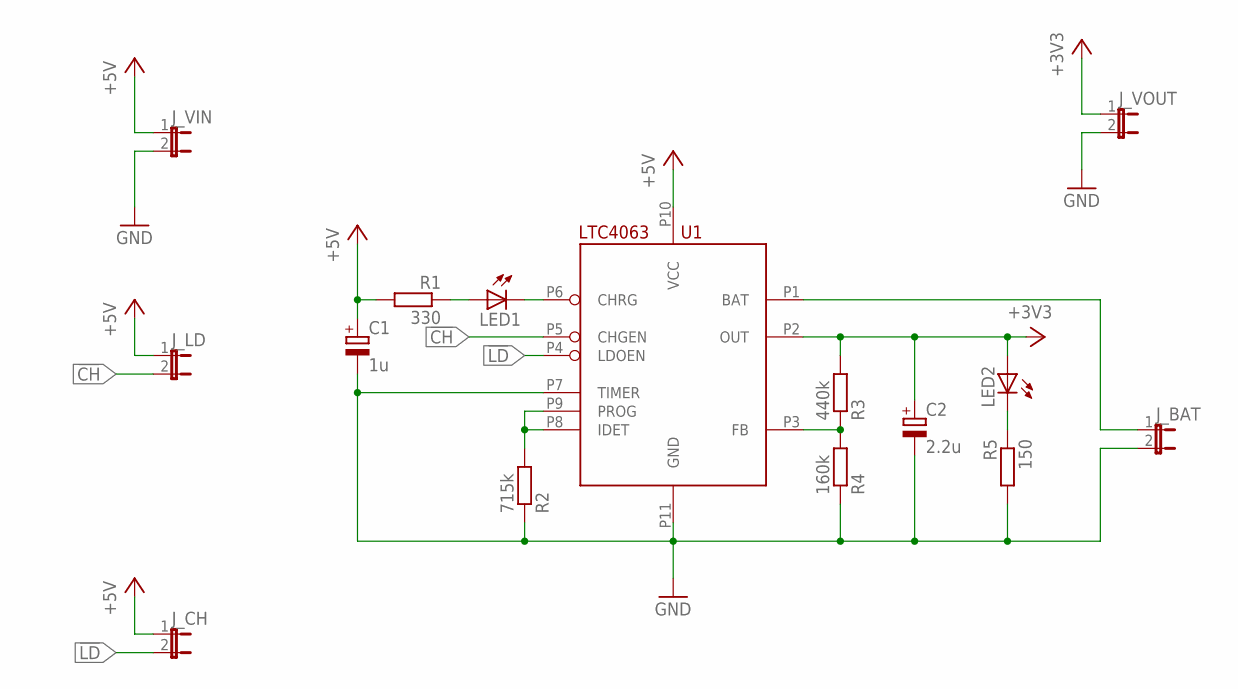
[picture p40: schematic LTC4063-TestBoard_nicht SMD.sch]

Parts:
C1: 1u; E2,5-6
C2: 2.2u; E2,5-6
J_BAT: JP1E; JP1
J_CH: JP1E; JP1
J_LD: JP1E; JP1
J_VIN: JP1E; JP1
J_VOUT: JP1E; JP1
LED1, LED2: LED3MM
R1: 330; 0207/7
R2: 715k; 0207/7
R3: 440k; 0207/7
R4: 160k; 0207/7
R5: 150; 0207/7
U1: LTC4063

Connections:
!CH: J_LD.2, U1.P5 (CHGEN)
!LD: J_CH.2, U1.P4 (LDOEN)
+3V3: C2.+, J_VOUT.1, LED2.A, R3.2, U1.P2 (OUT)
+5V: C1.+, J_CH.1, J_LD.1, J_VIN.1, R1.2, U1.P10 (VCC)
GND: C1.-, C2.-, J_BAT.2, J_VIN.2, J_VOUT.2, R2.1, R4.1, R5.2, U1.P7 (TIMER), U1.P11 (GND)
unnamed: R3.1, R4.2, U1.P3 (FB)
unnamed: J_BAT.1, U1.P1 (BAT)
unnamed: LED1.K (C), U1.P6 (CHRG)
unnamed: LED1.A, R1.1
unnamed: R2.2, U1.P8 (IDET), U1.P9 (PROG)
unnamed: LED2.K (C), R5.1

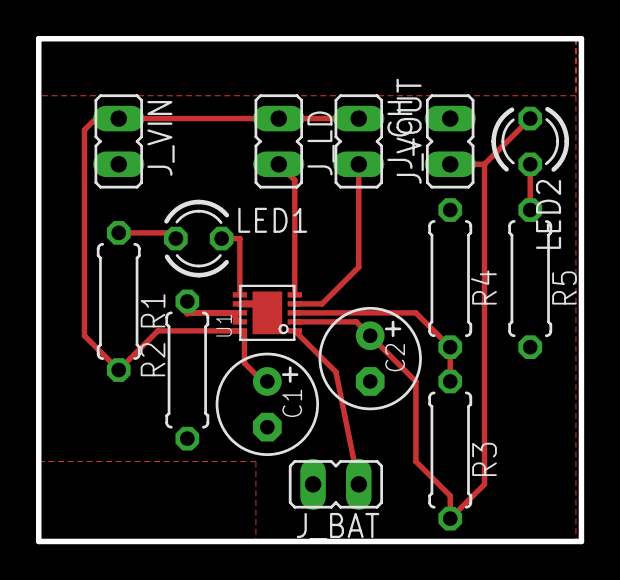
[picture p41: board LTC4063-TestBoard_nicht SMD.brd from above]

Board: 2 copper layers, 30.1 x 27.9 mm, 15 parts (0 on the bottom side), 11 nets.
