falkm1980/Mp3-Player_HTL/Testboard/SD_Kartenbuchse/SD_Card.brd

## EAGLE design Testboard/SD_Kartenbuchse/SD_Card.brd (2019-09-27)

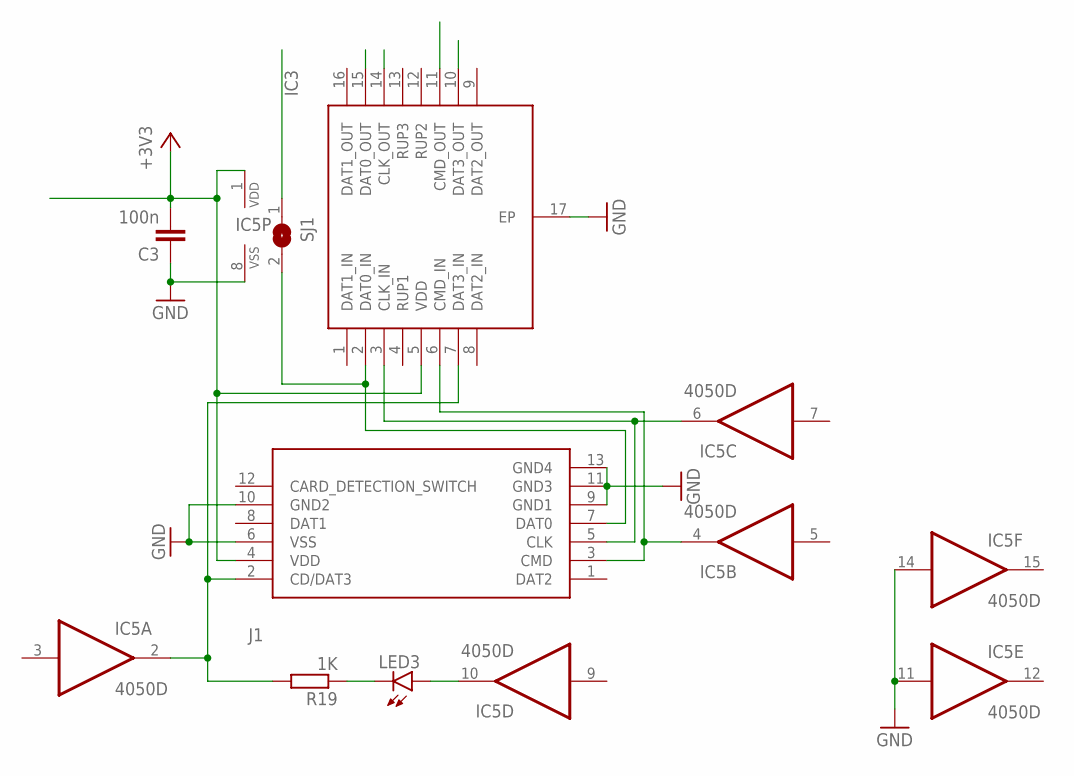
[picture p42: schematic SD_Card.sch]

Parts:
C3: 100n; C1206K
IC3: ECLAMP2410P.TCT; SON50P160X400X65-17N
IC5: 4050D; SO16
J1: DM3CS-SF
LED3: LG_T679-E1F1-1; PLCC2
R19: 1K; R1206
SJ1: SJ

Connections:
+3V3: C3.2, IC3.5 (VDD), IC5.1 (VDD), J1.4 (VDD)
GND: C3.1, IC3.17 (EP), IC5.8 (VSS), IC5.11 (I), IC5.14 (I), J1.6 (VSS), J1.9 (GND1), J1.10 (GND2), J1.11 (GND3), J1.13 (GND4)
unnamed: IC3.15 (DAT0_OUT), SJ1.1
unnamed: IC5.10 (O), LED3.A
unnamed: LED3.C, R19.1
unnamed: IC3.7 (DAT3_IN), IC5.2 (O), J1.2 (CD/DAT3), R19.2
unnamed: IC3.2 (DAT0_IN), J1.7 (DAT0), SJ1.2
unnamed: IC3.3 (CLK_IN), IC5.6 (O), J1.5 (CLK)
unnamed: IC3.6 (CMD_IN), IC5.4 (O), J1.3 (CMD)

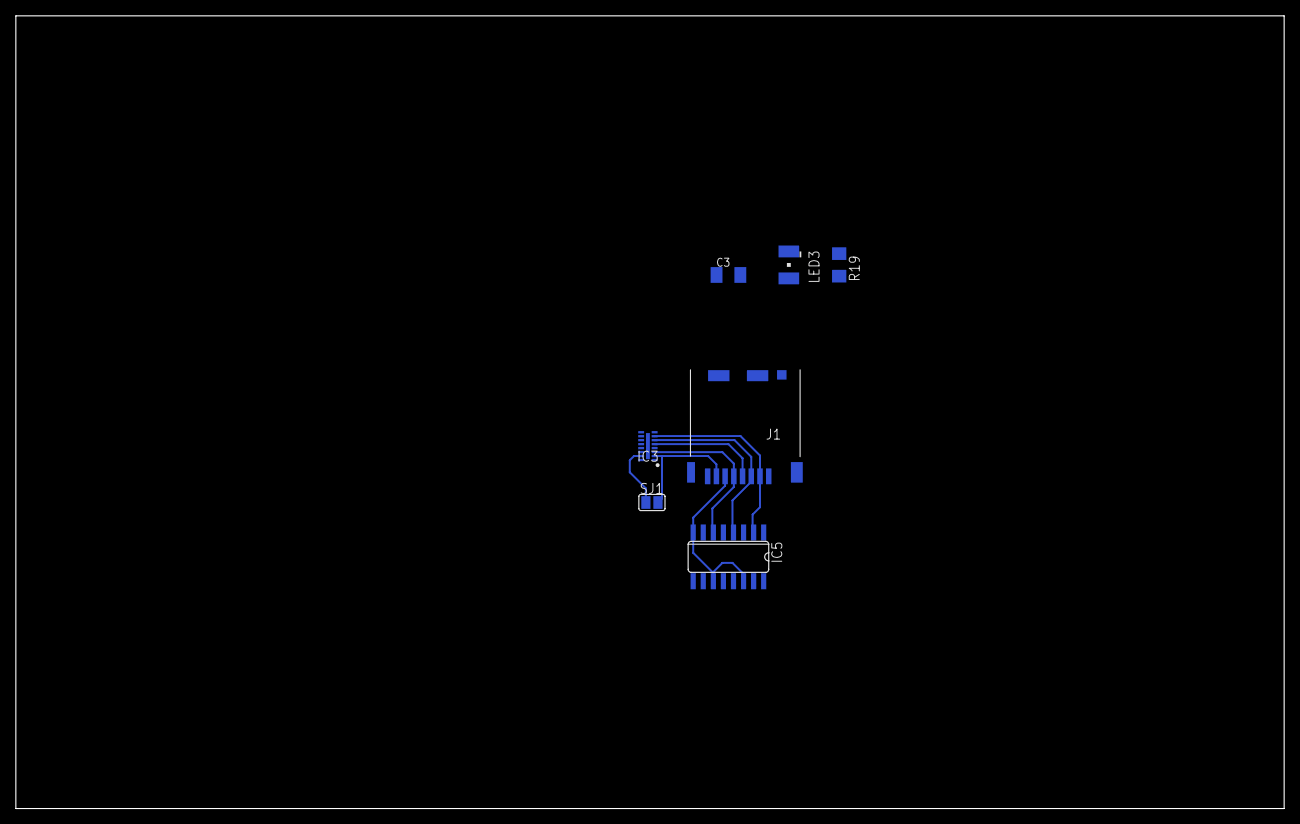
[picture p43: board SD_Card.brd from below]

Board: 2 copper layers, 160.0 x 100.0 mm, 7 parts (7 on the bottom side), 9 nets.
