falkm1980/Mp3-Player_HTL/MP3_Player/SD_Kartenleser/Mikro_SD_Karte.brd

## EAGLE design MP3_Player/SD_Kartenleser/Mikro_SD_Karte.brd (2019-09-27)

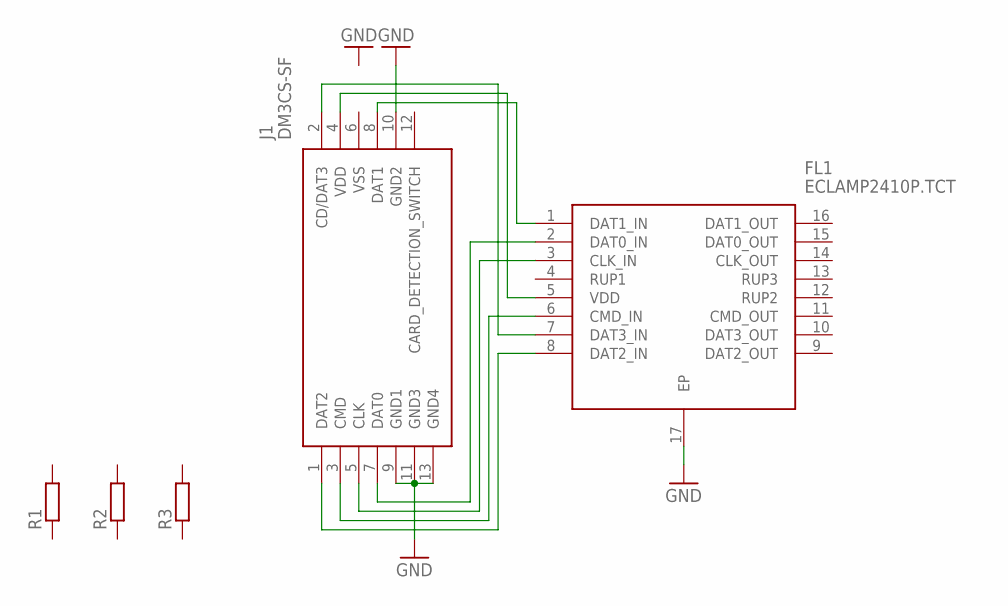
[picture p44: schematic Mikro_SD_Karte.sch]

Parts:
FL1: ECLAMP2410P.TCT; SON50P160X400X65-17N
J1: DM3CS-SF
R1, R2, R3: R-EU_R0603; R0603

Connections:
GND: FL1.17 (EP), J1.9 (GND1), J1.10 (GND2), J1.11 (GND3), J1.13 (GND4)
unnamed: FL1.1 (DAT1_IN), J1.8 (DAT1)
unnamed: FL1.8 (DAT2_IN), J1.1 (DAT2)
unnamed: FL1.5 (VDD), J1.4 (VDD)
unnamed: FL1.7 (DAT3_IN), J1.2 (CD/DAT3)
unnamed: FL1.2 (DAT0_IN), J1.7 (DAT0)
unnamed: FL1.3 (CLK_IN), J1.5 (CLK)
unnamed: FL1.6 (CMD_IN), J1.3 (CMD)

Board: 2 copper layers, 5 parts (0 on the bottom side), 8 nets, no tracks yet.
