falkm1980/Mp3-Player_HTL/Testboard/Platinenlayout/Testboard_1.3.brd

## EAGLE design Testboard/Platinenlayout/Testboard_1.3.brd (2019-09-27)

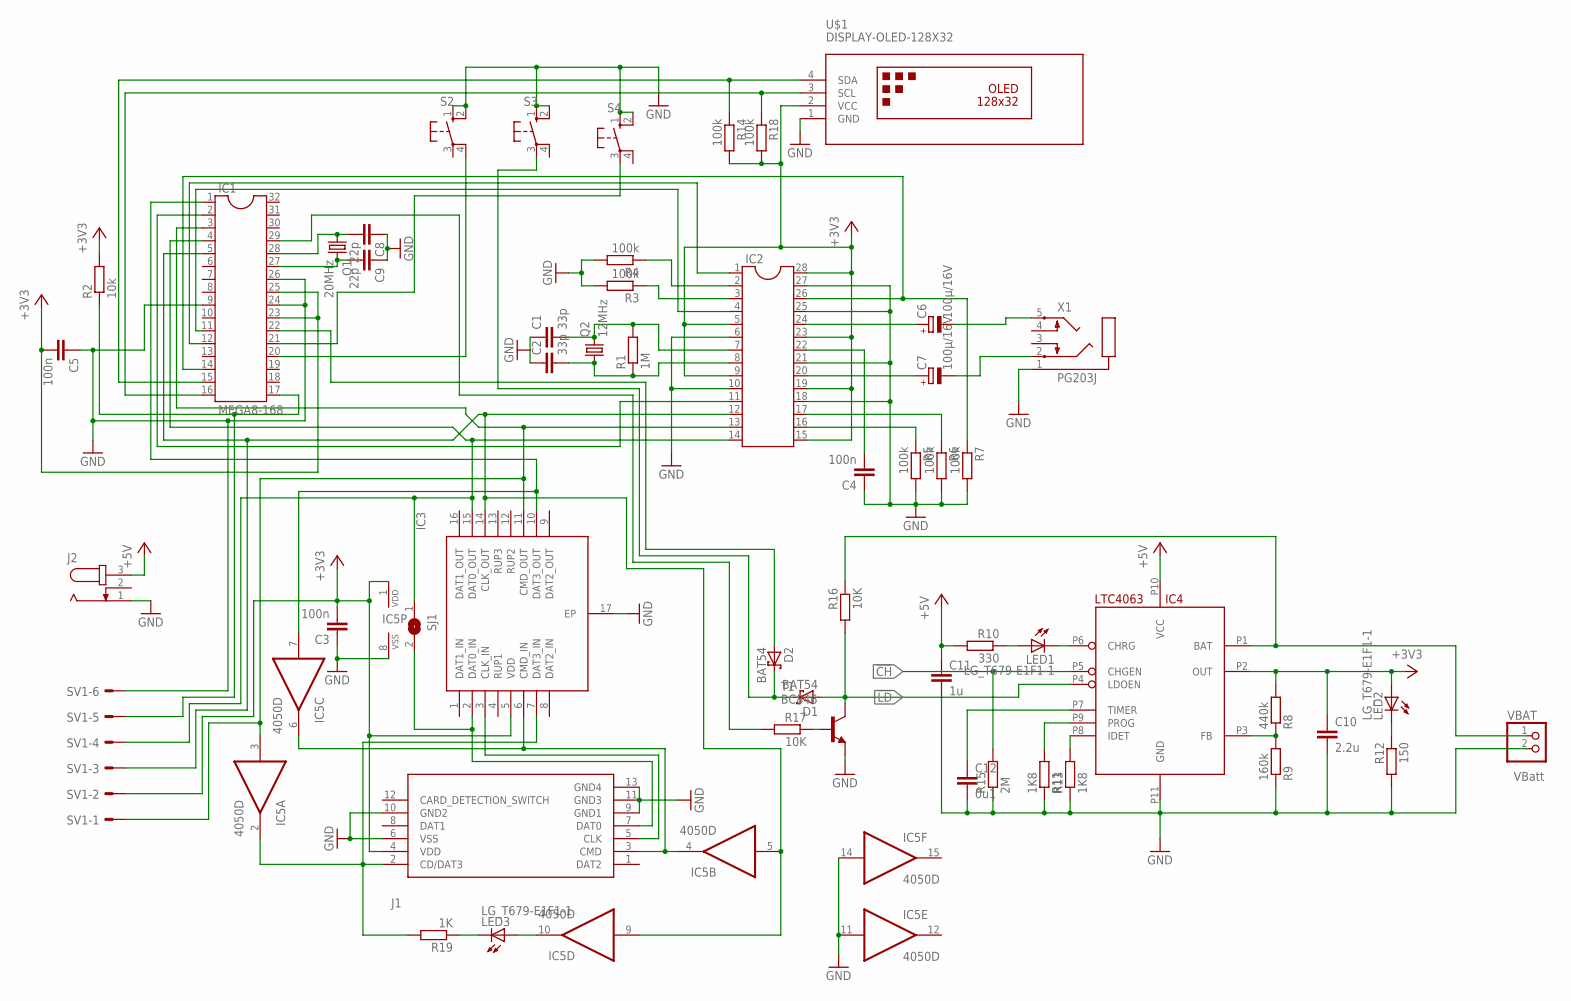
[picture p45: schematic Testboard_1.3.sch]

Parts:
C1, C2: 33p; C1206K
C3, C4, C5: 100n; C1206K
C6, C7: 100µ/16V; UD-6,3X7,7_NICHICON
C8, C9: 22p; C1206K
C10: 2.2u; C0805K
C11: 1u; C0805K
C12: 0u1; C0805K
D1, D2: BAT54; SOT23
IC1: MEGA8-168; DIL32
IC2: DIL28-3
IC3: ECLAMP2410P.TCT; SON50P160X400X65-17N
IC4: LTC4063
IC5: 4050D; SO16
J1: DM3CS-SF
J2: JACK-PLUG0; SPC4077
LED1, LED2, LED3: LG_T679-E1F1-1; LED5MM
Q1: 20MHz; HC49UP
Q2: 12MHz; HC49UP
R1: 1M; R0805
R2: 10k; 0207/10
R3, R4, R7, R14, R18: 100k; R1206
R5, R6: 100k; R0805
R8: 440k; R0805
R9: 160k; R0805
R10: 330; R0805
R11: 1K8; R0805
R12: 150; R0805
R13: 1K8; R1206
R15: 2M; R0805
R16: 10K; 0207/10
R17: 10K; R0805
R19: 1K; R1206
S2, S3, S4: 10-XX; B3F-10XX
SJ1: SJ
SV1: ML6E; ML6
T1: BC846; SOT23
U$1: DISPLAY-OLED-128X32
VBAT: PINHD-1X2; 1X02
X1: PG203J

Connections:
!CH: IC4.P5 (CHGEN), R15.2
!LD: D1.1 (A), IC4.P4 (LDOEN), R16.2, T1.3 (C)
+3V3: C3.2, C5.2, C10.1, IC1.23, IC1.25, IC2.5, IC2.9, IC2.15, IC2.19, IC2.23, IC2.28, IC3.5 (VDD), IC4.P2 (OUT), IC5.1 (VDD), J1.4 (VDD), LED2.A, R2.2, R8.2, R14.2, R18.2, SV1.2, U$1.2 (VCC)
+5V: C11.1, IC4.P10 (VCC), J2.3, R10.2
GND: C1.1, C2.1, C3.1, C4.1, C5.1, C8.1, C9.1, C10.2, C11.2, C12.2, IC1.9, IC1.24, IC1.26, IC2.6, IC2.10, IC2.18, IC2.21, IC2.25, IC2.27, IC3.17 (EP), IC4.P11 (GND), IC5.8 (VSS), IC5.11 (I), IC5.14 (I), J1.6 (VSS), J1.9 (GND1), J1.10 (GND2), J1.11 (GND3), J1.13 (GND4), J2.1, R3.2, R4.2, R5.2, R6.2, R7.2, R9.1, R11.1, R12.2, R13.1, R15.1, S2.1 (S), S2.2 (S1), S3.1 (S), S3.2 (S1), S4.1 (S), S4.2 (S1), SV1.6, T1.2 (E), U$1.1 (GND), VBAT.2, X1.1
unnamed: IC1.4, IC2.14, IC3.15 (DAT0_OUT), SJ1.1, SV1.4
unnamed: IC1.5, IC2.12, IC3.14 (CLK_OUT), IC5.5 (I), IC5.9 (I), SV1.3
unnamed: IC1.2, IC2.11
unnamed: C2.2, IC2.8, Q2.1, R1.1
unnamed: IC1.11, IC2.4
unnamed: C4.2, IC2.22
unnamed: IC2.3, R3.1
unnamed: C1.2, IC2.7, Q2.2, R1.2
unnamed: IC2.2, R4.1
unnamed: IC1.20, S2.4 (P1)
unnamed: IC2.17, R6.1
unnamed: IC2.16, R5.1
unnamed: IC1.12, IC2.1
unnamed: D2.1 (A), IC1.22
unnamed: IC1.14, IC2.26, R7.1
unnamed: IC5.10 (O), LED3.A
unnamed: C7.+, IC2.20
unnamed: C6.+, IC2.24
unnamed: IC1.21, S4.3
unnamed: C6.-, X1.5
unnamed: C7.-, X1.2
unnamed: C8.2, IC1.28, Q1.1
unnamed: C9.2, IC1.27, Q1.2
unnamed: LED3.K (C), R19.1
unnamed: IC1.17, R2.1, SV1.5
unnamed: IC4.P3 (FB), R8.1, R9.2
unnamed: IC3.7 (DAT3_IN), IC5.2 (O), J1.2 (CD/DAT3), R19.2
unnamed: IC3.2 (DAT0_IN), J1.7 (DAT0), SJ1.2
unnamed: IC3.3 (CLK_IN), J1.5 (CLK)
unnamed: IC3.6 (CMD_IN), IC5.4 (O), IC5.6 (O), J1.3 (CMD)
unnamed: IC4.P1 (BAT), R16.1, VBAT.1
unnamed: LED1.A, R10.1
unnamed: IC4.P9 (PROG), R11.2
unnamed: IC4.P6 (CHRG), LED1.K (C)
unnamed: LED2.K (C), R12.1
unnamed: IC4.P8 (IDET), R13.2
unnamed: C12.1, IC4.P7 (TIMER)
unnamed: IC1.15, R14.1, U$1.4 (SDA)
unnamed: IC1.16, R18.1, U$1.3 (SCL)
unnamed: IC1.3, IC2.13, IC3.11 (CMD_OUT), IC5.3 (I), SV1.1
unnamed: IC1.1, IC3.10 (DAT3_OUT), IC5.7 (I)
unnamed: R17.1, T1.1 (B)
unnamed: IC1.29, R17.2
unnamed: D1.3 (C), D2.3 (C), S3.3

Notes on the sheet:
VBatt

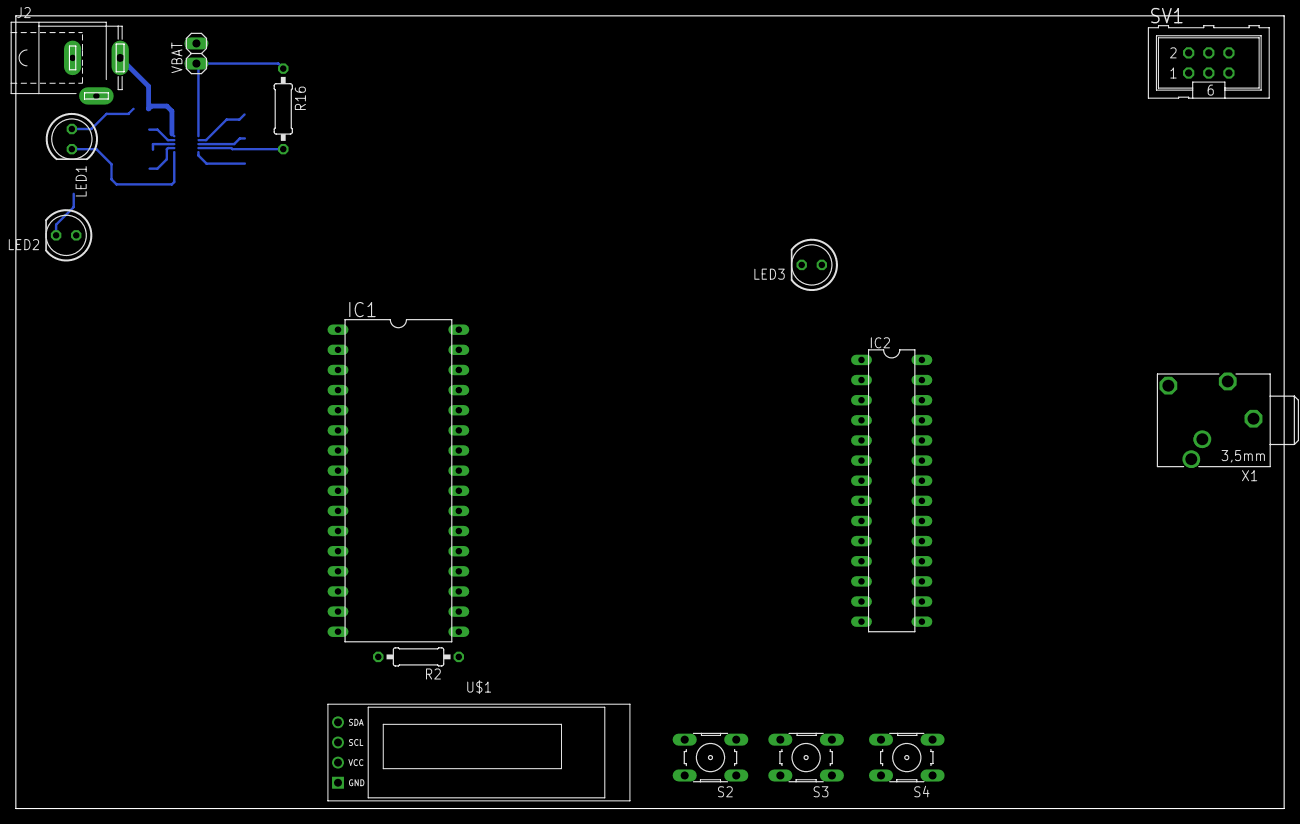
[picture p46: board Testboard_1.3.brd from above]

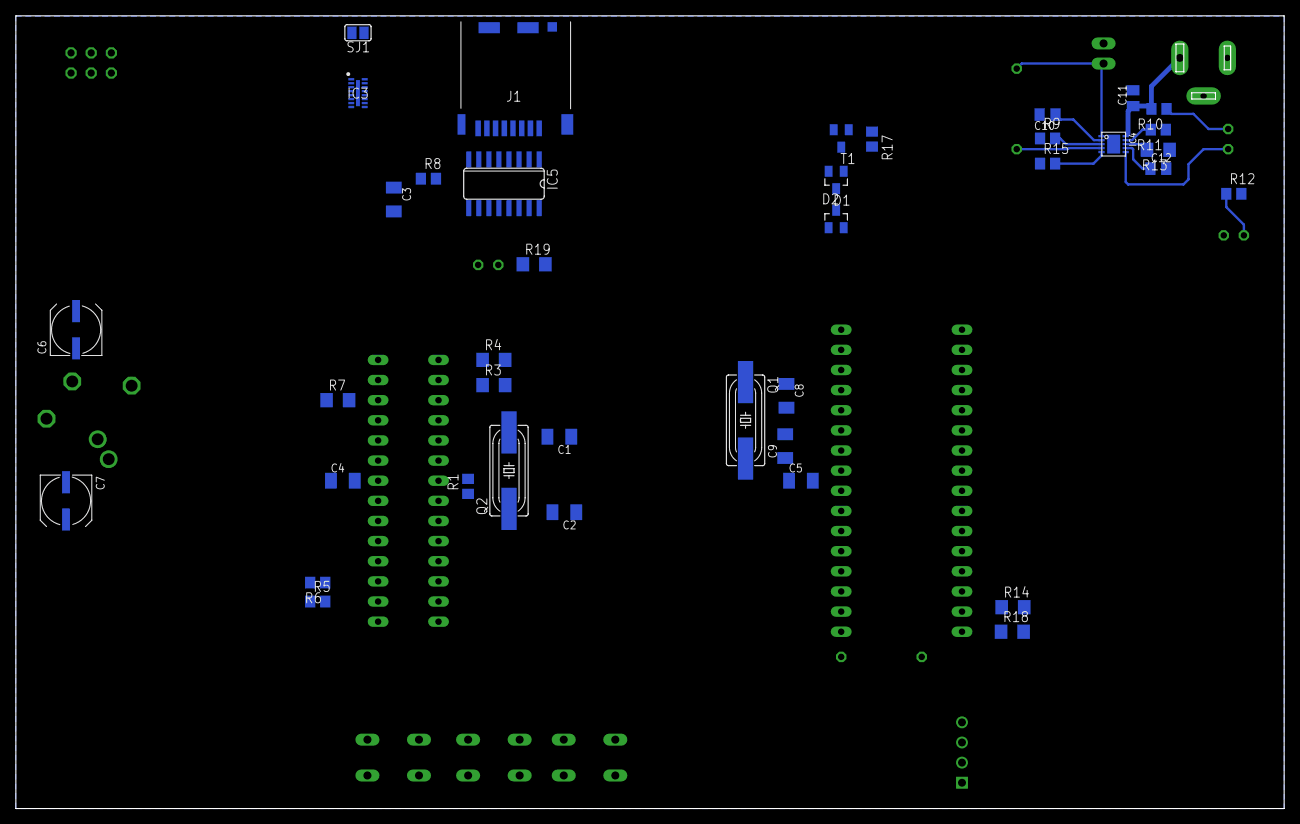
[picture p47: board Testboard_1.3.brd from below]

Board: 2 copper layers, 160.0 x 100.0 mm, 54 parts (39 on the bottom side), 49 nets.
