falkm1980/Mp3-Player_HTL/MP3_Player/Platine_Version_5/mp3player_v5_Laderegler.brd

## EAGLE design MP3_Player/Platine_Version_5/mp3player_v5_Laderegler.brd (2019-09-27, an earlier design)

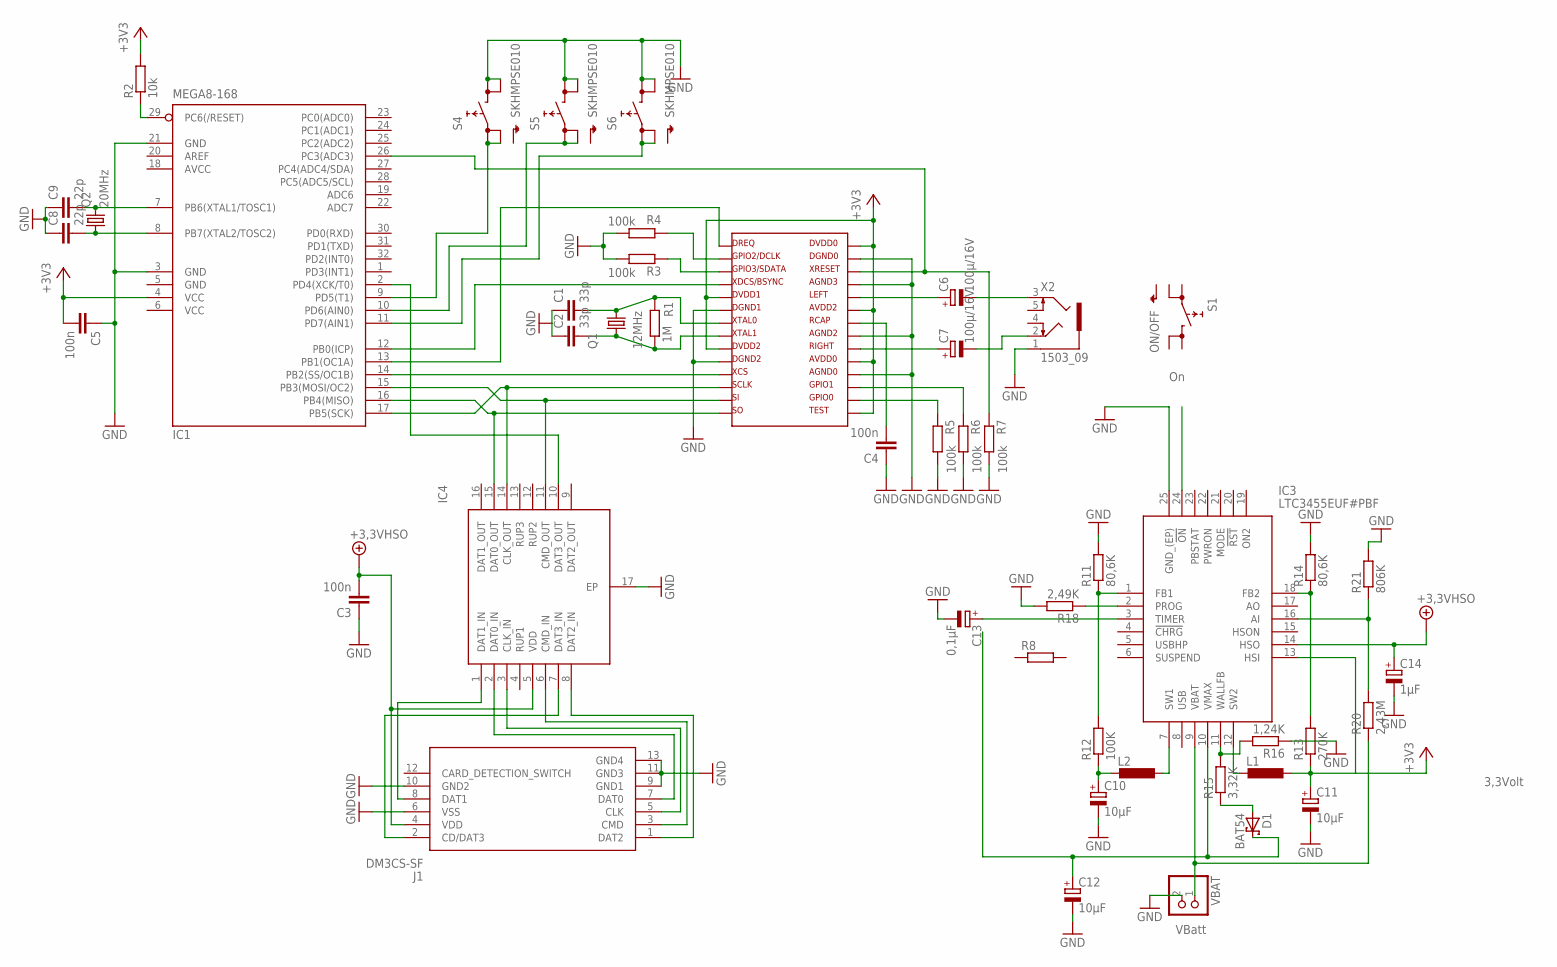
[picture p48: schematic mp3player_v5_Laderegler.sch]

Parts:
C1, C2: 33p; C1206K
C3, C4, C5: 100n; C1206K
C6, C7: 100µ/16V; UD-6,3X7,7_NICHICON
C8, C9: 22p; C1206K
C10, C11, C12: 10µF; 153CLV-0505
C13: 0,1µF; B/3528-21W
C14: 1µF; B/3528-21W
D1: BAT54; SOT23
IC1: MEGA8-168; TQFP32-08
IC2: VS1011; SOIC-28
IC3: LTC3455EUF#PBF; QFN50P400X400X80-25N
IC4: ECLAMP2410P.TCT; SON50P160X400X65-17N
J1: DM3CS-SF
L1, L2: L-EUL2825P; L2825P
Q1: 12MHz; HC49UP
Q2: 20MHz; HC49UP
R1: 1M; R0805
R2: 10k; R0805
R3, R4, R5, R6, R7: 100k; R0805
R8: R-EU_R0805; R0805
R11, R14: 80,6K; R0805
R12: 100K; M1206
R13: 270K; M1206
R15: 3,32K; M1206
R16: 1,24K; M1206
R18: 2,49K; R0805
R20: 2,43M; M1206
R21: 806K; R0805
S1: ON/OFF; SKHMPXE010
S4, S5, S6: SKHMPSE010; SKHMPXE010
VBAT: PINHD-1X2; 1X02
X2: 1503_09

Connections:
+3,3VHSO: C3.2, C14.+, IC3.14 (HSO), IC4.5 (VDD), J1.4 (VDD)
+3V3: C5.2, C11.+, IC1.4 (VCC), IC2.5, IC2.9, IC2.15, IC2.19, IC2.23, IC2.28, IC3.13 (HSI), L1.1, R2.2, R13.1
AVCC: IC1.18 (AVCC)
GND: C1.1, C2.1, C3.1, C4.1, C5.1, C8.1, C9.1, C10.-, C11.-, C12.-, C13.-, C14.-, IC1.3 (GND), IC1.5 (GND), IC1.21 (GND), IC2.6, IC2.10, IC2.18, IC2.21, IC2.25, IC2.27, IC3.25 (GND_(EP)), IC4.17 (EP), J1.6 (VSS), J1.9 (GND1), J1.10 (GND2), J1.11 (GND3), J1.13 (GND4), R3.2, R4.2, R5.2, R6.2, R7.2, R11.2, R14.2, R16.1, R18.2, R21.2, S4.3 (2.1), S4.4 (2.2), S5.3 (2.1), S5.4 (2.2), S6.3 (2.1), S6.4 (2.2), VBAT.2, X2.1
unnamed: IC1.17 (PB5(SCK)), IC2.12, IC4.14 (CLK_OUT)
unnamed: IC1.16 (PB4(MISO)), IC2.14, IC4.15 (DAT0_OUT)
unnamed: IC1.15 (PB3(MOSI/OC2)), IC2.13, IC4.11 (CMD_OUT)
unnamed: IC1.14 (PB2(SS/OC1B)), IC2.11
unnamed: IC1.2 (PD4(XCK/T0)), IC4.10 (DAT3_OUT)
unnamed: C2.2, IC2.8, Q1.1, R1.1
unnamed: IC1.12 (PB0(ICP)), IC2.4
unnamed: C4.2, IC2.22
unnamed: IC2.3, R3.1
unnamed: C1.2, IC2.7, Q1.2, R1.2
unnamed: IC2.2, R4.1
unnamed: IC1.9 (PD5(T1)), S4.1 (1.1), S4.2 (1.2)
unnamed: IC2.17, R6.1
unnamed: IC2.16, R5.1
unnamed: IC1.13 (PB1(OC1A)), IC2.1
unnamed: IC1.10 (PD6(AIN0)), S5.1 (1.1), S5.2 (1.2)
unnamed: IC1.26 (PC3(ADC3)), IC2.26, R7.1
unnamed: IC1.29 (PC6(/RESET)), R2.1
unnamed: C7.+, IC2.20
unnamed: C6.+, IC2.24
unnamed: IC1.11 (PD7(AIN1)), S6.1 (1.1), S6.2 (1.2)
unnamed: C6.-, X2.3
unnamed: C7.-, X2.2
unnamed: C8.2, IC1.8 (PB7(XTAL2/TOSC2)), Q2.1
unnamed: C9.2, IC1.7 (PB6(XTAL1/TOSC1)), Q2.2
unnamed: IC4.1 (DAT1_IN), J1.8 (DAT1)
unnamed: IC4.8 (DAT2_IN), J1.1 (DAT2)
unnamed: IC3.12 (SW2), L1.2
unnamed: IC4.7 (DAT3_IN), J1.2 (CD/DAT3)
unnamed: IC4.2 (DAT0_IN), J1.7 (DAT0)
unnamed: IC4.3 (CLK_IN), J1.5 (CLK)
unnamed: IC4.6 (CMD_IN), J1.3 (CMD)
unnamed: IC3.7 (SW1), L2.1
unnamed: IC3.1 (FB1), R11.1, R12.2
unnamed: C10.+, L2.2, R12.1
unnamed: IC3.18 (FB2), R13.2, R14.1
unnamed: IC3.9 (VBAT), R20.1, VBAT.1
unnamed: C12.+, D1.3 (C), IC3.10 (VMAX)
unnamed: IC3.11 (WALLFB), R15.2, R16.2
unnamed: D1.1 (A), R15.1
unnamed: IC3.2 (PROG), R18.1
unnamed: C13.+, IC3.3 (TIMER)
unnamed: IC3.16 (AI), R20.2, R21.1
VCC: IC1.6 (VCC)

Notes on the sheet:
3,3Volt
VBatt

Board: 2 copper layers, 47 parts (45 on the bottom side), 46 nets, no tracks yet.
