falkm1980/Mp3-Player_HTL/(commit log)

2019-05-24 first working version after redesign
    [Mp3-Player.c, mmc.c, spi.c]
2019-05-24 Layout Hinzugefügt
    [mp3player_v6_Laderegler_LTC4063.brd, mp3player_v6_Laderegler_LTC4063.sch]
2019-09-27 updated version from Herbert
    [LTC4063-TestBoard.brd, LTC4063-TestBoard.sch, LTC4063-TestBoard_nicht SMD.brd, LTC4063-TestBoard_nicht SMD.sch, MP3_Player_Stückliste.xlsx, MP3_Testboard.brd, MP3_Testboard.sch, Mikro_SD_Karte.brd]
2019-10-05 added EvaluationBoard Labor
    [ATmega328P_Xplained_Mini.PrjPCB, ATmega328P_Xplained_Mini_Programmer.SchDoc, ATmega328P_Xplained_Mini_Target.SchDoc, ATmega328P_Xplained_Mini_TopLevel.SchDoc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]
2019-10-09 update schematic
    [mp3playerLabor_v1.brd, mp3playerLabor_v1.sch]
2019-10-11 DisplayTest added
    [mp3playerLabor_v1.brd, mp3playerLabor_v1.sch]
2019-10-12 update pcb
    [mp3playerLabor_v1.brd, mp3playerLabor_v1.sch]
2019-10-12 pcb finished, 1st version
    [mp3playerLabor_v1.brd, mp3playerLabor_v1.sch]
2019-10-12 pcb finished and order sent to jlcpcb
    [mp3playerLabor_v1.brd, mp3playerLabor_v1.sch]
2019-10-22 GPIO und Serial Test programs added
2020-01-17 rework of keyboard handling
    added function to switch off the MP3-Player
    [Mp3-Player.c, main.c]
2020-10-26 Sinus removed in case of error
    [Mp3-Player.c]
2023-04-14 Sinus in case that SD-card cannot be read added
    3 peep when SD card mount fails and then shutdown the player
    [Mp3-Player.c]
2023-09-28 PDF of schematic added
