falkm1980/Mp3-Player_HTL/(notices)

Notices in the files:
parts and their libraries:
LinearTechnology: Copyright (c) 2013, Michael Hohl
diy-modules: Released under the Creative Commons Attribution 4.0 International License: http://creativecommons.org/licenses/by/4.0
